open3dengineering/i3_Berlin/Firmware/RUMBA/README.md

Marlin Firmware for the I3 Berlin
=============

This is a preconfigured Marlin Firmware for the O3DE-Prusa I3. 

*original [https://github.com/ErikZalm/Marlin/](https://github.com/ErikZalm/Marlin/).*

Installation Instructions:
-------------
* Download Arduino 1.0.5 from *[http://arduino.cc/en/Main/Software](http://arduino.cc/en/Main/Software).*
* Install /ArduinoAddons/Arduino_1.x.x/u8glib_arduino_v1.12.zip into your Arduino library directory *see [http://arduino.cc/en/Guide/Libraries](http://arduino.cc/en/Guide/Libraries)*
* To use the RUMBA board on Windows 8/7/Vista/XP 32 and 64 bit install the USB driver from [http://reprap.org/wiki/File:RRD_RUMBA_TAURINO_DriverSetup.zip](http://reprap.org/wiki/File:RRD_RUMBA_TAURINO_DriverSetup.zip)
* If you have a songle Extruder cp the file Configuration.h.single to Configuration.h, for a dual Extruder cp Configuration.h.dual to Configuration.h 
* Open /Marlin/Marlin.ino with the Arduino IDE 
* set your Boardtype to "Arduino Mega 2560" and select the coresponding serial interface
* upload the Firmware ( File->Upload )
