open3dengineering/i3_Berlin/Stls/CableHolder.stl

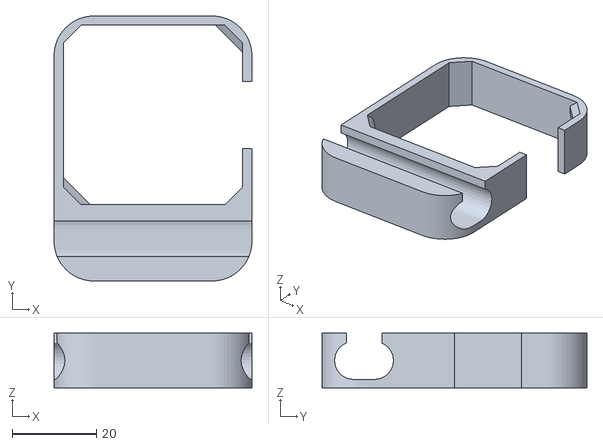
[picture p2: CAD file, 2015-07-06]
Stls/CableHolder.stl
47.1 x 63.1 x 13.0
