open3dengineering/i3_Berlin/Stls/ExtruderCenterRight.stl

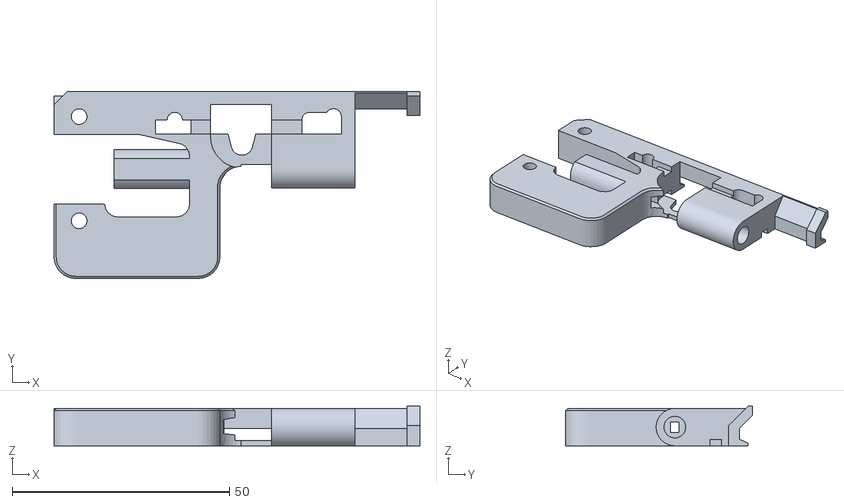
[picture p3: CAD file, 2015-04-21]
Stls/ExtruderCenterRight.stl
84.2 x 43.0 x 9.10
