open3dengineering/i3_Berlin/Stls/X_Carriage.stl

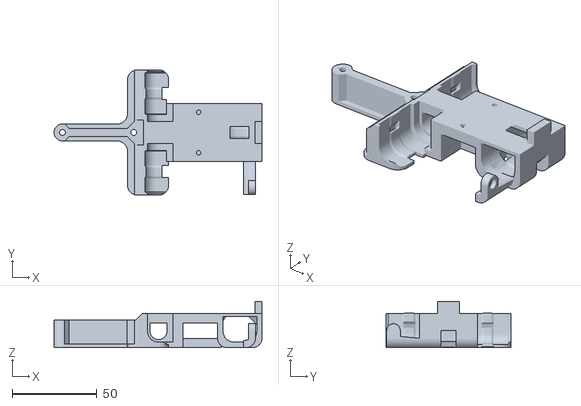
[picture p4: CAD file, 2015-04-21]
Stls/X_Carriage.stl
122.7 x 74.0 x 27.2
