open3dengineering/i3_Berlin/Stls/Y_Teeth.stl

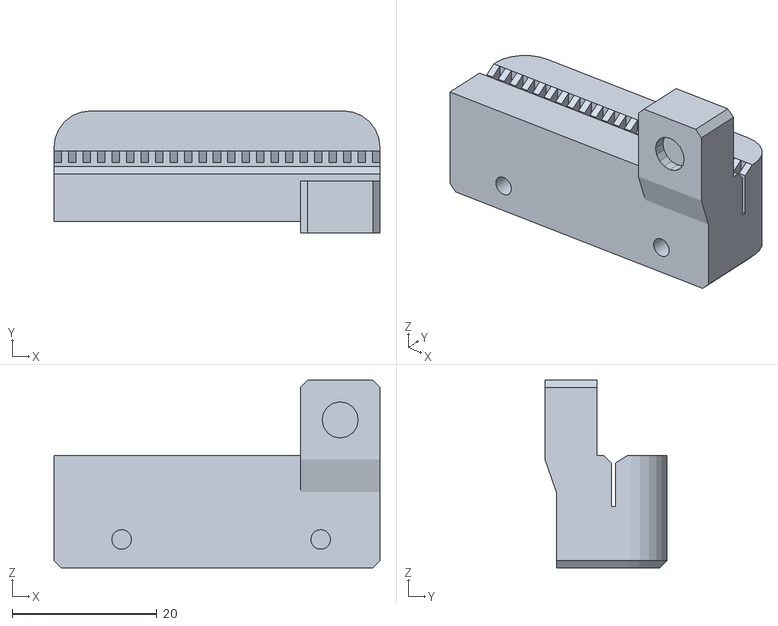
[picture p5: CAD file, 2015-02-04]
Stls/Y_Teeth.stl
45.0 x 16.9 x 25.9
