open3dengineering/i3_Berlin/Stls/Z_MotorLeft.stl

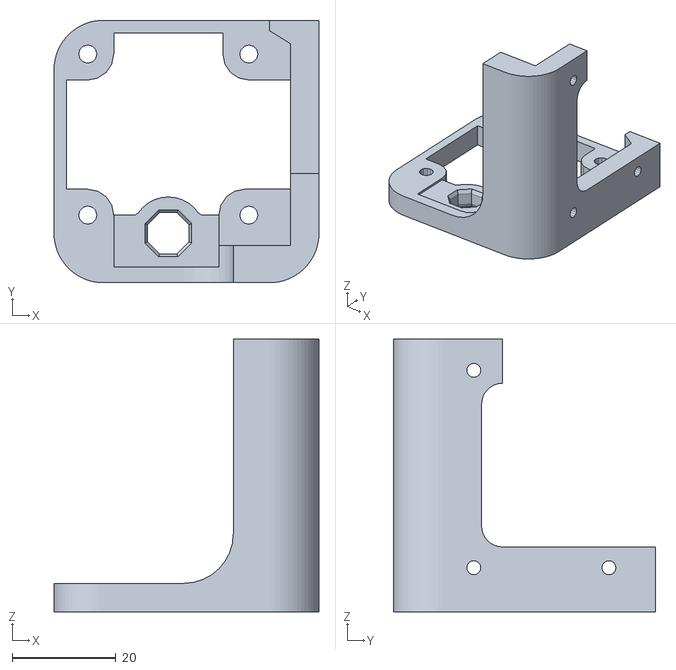
[picture p6: CAD file, 2015-02-04]
Stls/Z_MotorLeft.stl
51.0 x 50.5 x 52.5
