open3dengineering/i3_Berlin/Stls/Y_HeightAdjuster.stl

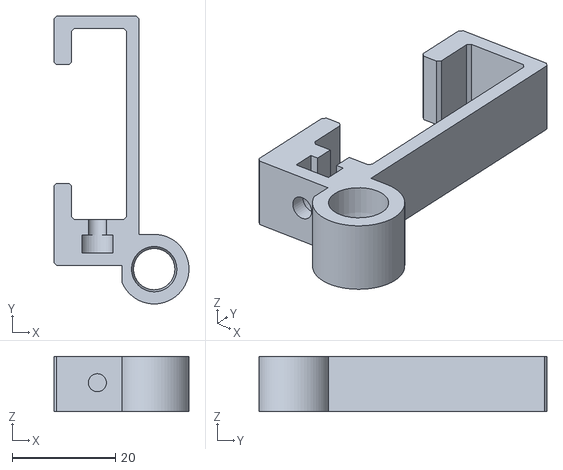
[picture p7: CAD file, 2015-02-04]
Stls/Y_HeightAdjuster.stl
26.1 x 55.7 x 10.7
