open3dengineering/i3_Berlin/Stls/DisplayCaseCorner.stl

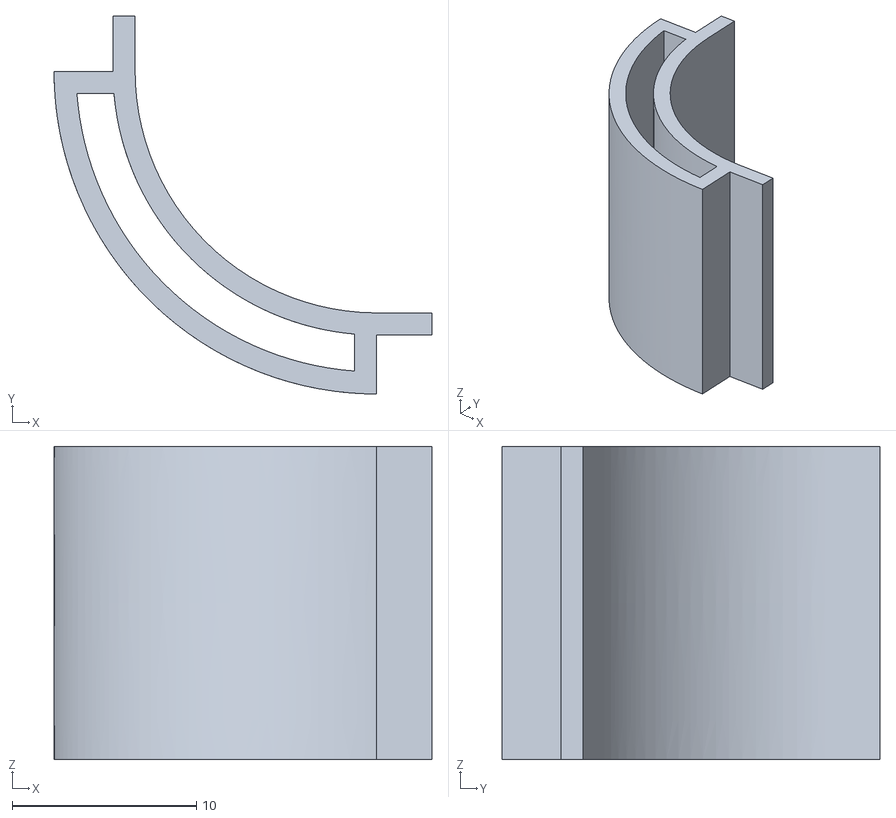
[picture p8: CAD file, 2015-02-04]
Stls/DisplayCaseCorner.stl
20.5 x 20.5 x 17.0
