open3dengineering/i3_Berlin/Stls/Z_TopLeft.stl

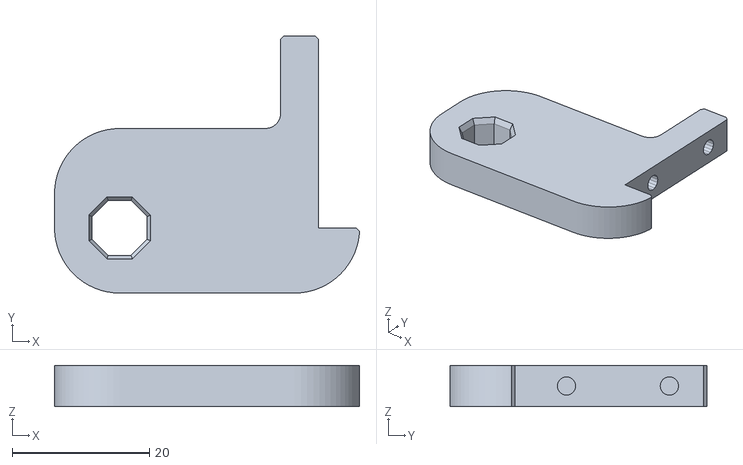
[picture p9: CAD file, 2015-02-04]
Stls/Z_TopLeft.stl
44.5 x 37.5 x 6.00
