open3dengineering/i3_Berlin/Stls/Y_FrontRight.stl

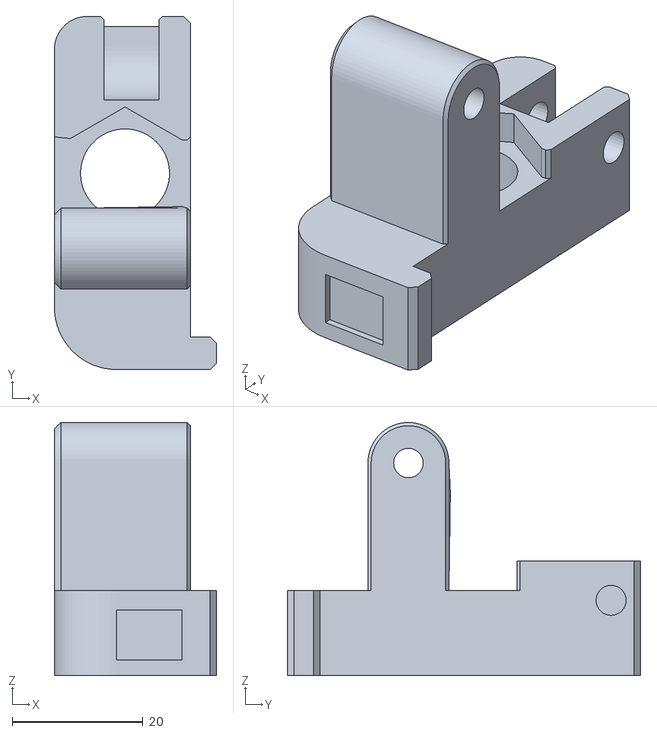
[picture p10: CAD file, 2015-02-04]
Stls/Y_FrontRight.stl
24.8 x 54.0 x 38.7
