open3dengineering/i3_Berlin/Stls/XZ_BearingHolderRight.stl

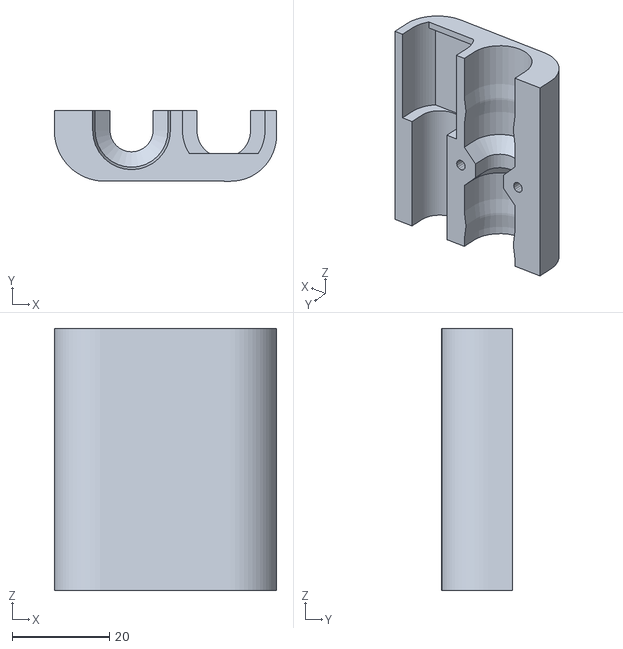
[picture p11: CAD file, 2015-02-04]
Stls/XZ_BearingHolderRight.stl
45.8 x 14.5 x 54.0
