open3dengineering/i3_Berlin/Stls/RUMBA_Case_SmallCorner.stl

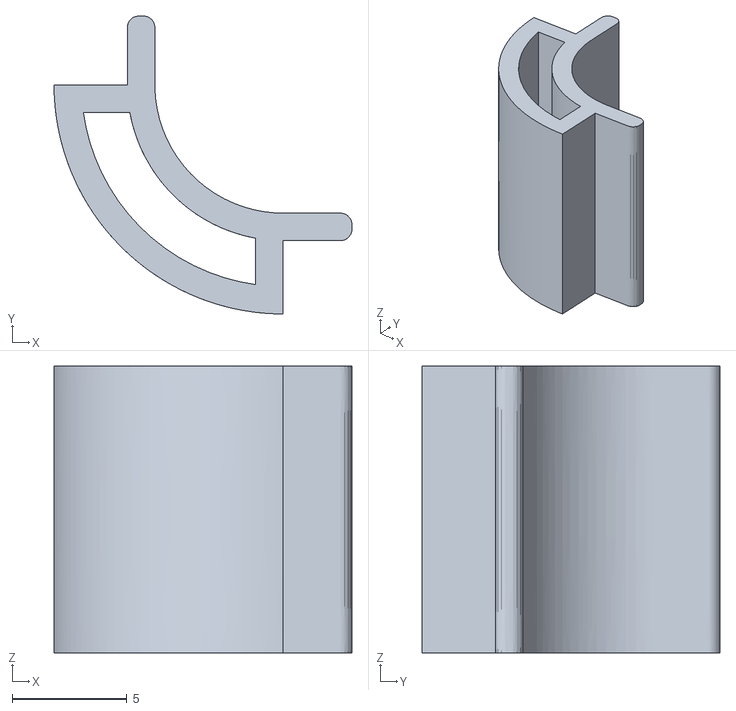
[picture p12: CAD file, 2015-02-04]
Stls/RUMBA_Case_SmallCorner.stl
13.0 x 13.0 x 12.5
