open3dengineering/i3_Berlin/Stls/RUMBA_Case_FanHolder.stl

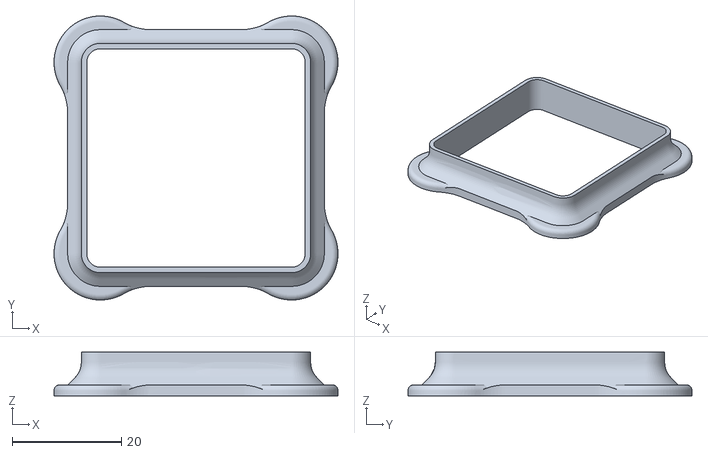
[picture p13: CAD file, 2015-02-04]
Stls/RUMBA_Case_FanHolder.stl
52.0 x 52.0 x 8.00
