open3dengineering/i3_Berlin/Stls/XZ_BearingHolderLeft.stl

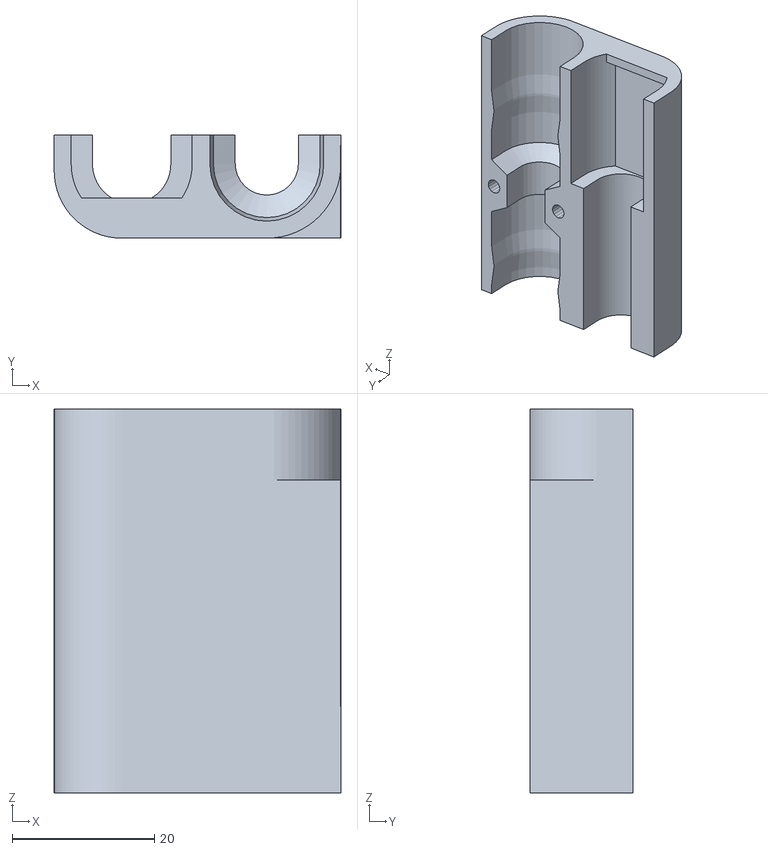
[picture p14: CAD file, 2015-02-04]
Stls/XZ_BearingHolderLeft.stl
40.3 x 14.5 x 54.0
