open3dengineering/i3_Berlin/Stls/Y_Motor.stl

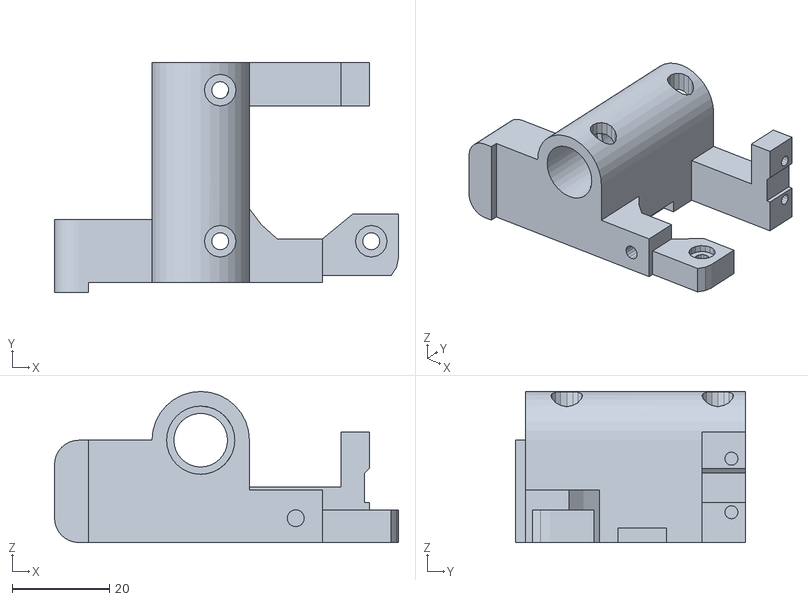
[picture p15: CAD file, 2015-02-04]
Stls/Y_Motor.stl
70.6 x 47.1 x 31.0
