open3dengineering/i3_Berlin/Stls/RUMBA_Case_LargeCorner.stl

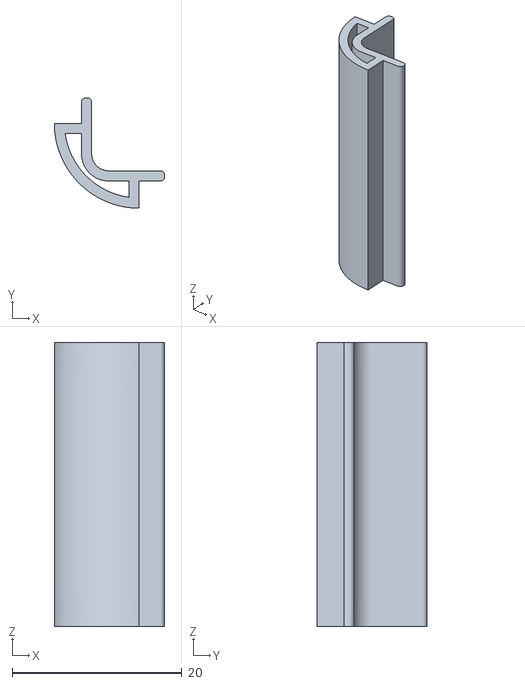
[picture p16: CAD file, 2015-02-04]
Stls/RUMBA_Case_LargeCorner.stl
13.0 x 13.0 x 33.4
