open3dengineering/i3_Berlin/Stls/ExtruderFanHolder.stl

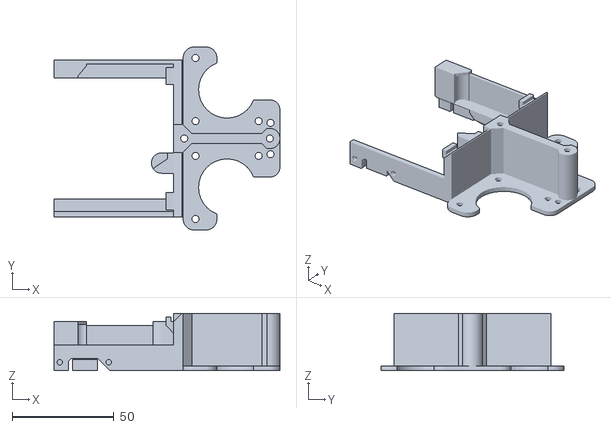
[picture p17: CAD file, 2015-02-04]
Stls/ExtruderFanHolder.stl
111.0 x 90.0 x 28.2
