open3dengineering/i3_Berlin/Stls/Y_BackLeft.stl

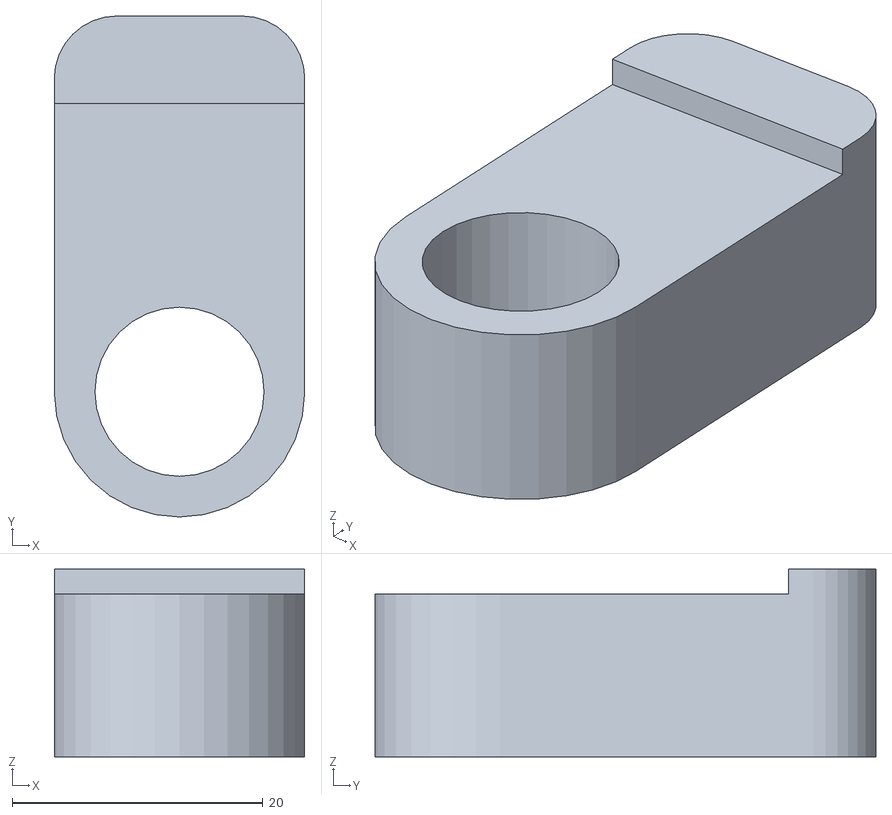
[picture p18: CAD file, 2015-02-04]
Stls/Y_BackLeft.stl
20.0 x 40.0 x 15.0
