open3dengineering/i3_Berlin/Stls/PowerConnectorCover.stl

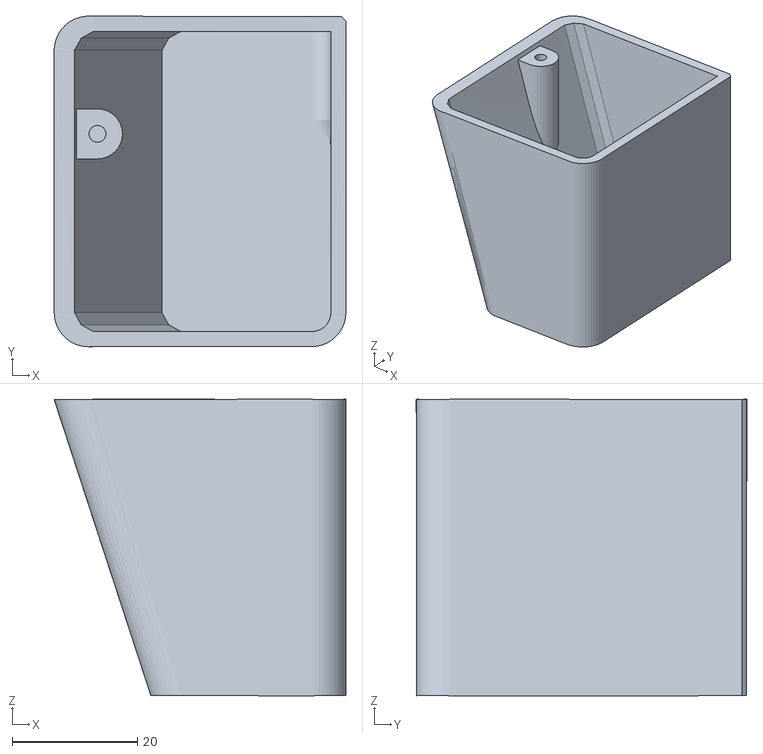
[picture p19: CAD file, 2015-02-04]
Stls/PowerConnectorCover.stl
46.7 x 52.9 x 47.5
