open3dengineering/i3_Berlin/Stls/Y_MiddleLeft.stl

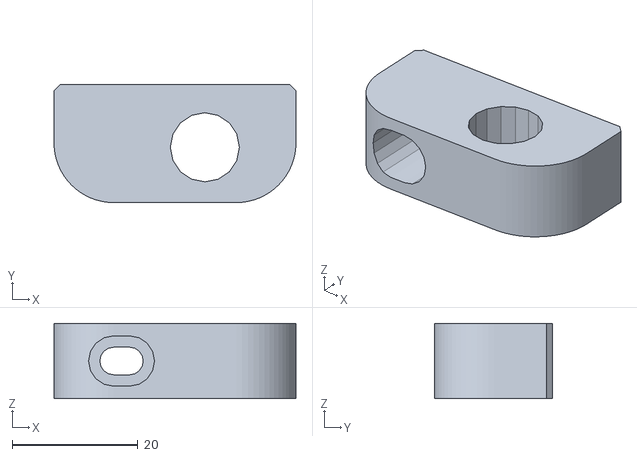
[picture p20: CAD file, 2015-02-04]
Stls/Y_MiddleLeft.stl
38.5 x 18.8 x 12.0
