open3dengineering/i3_Berlin/Stls/X_Idler.stl

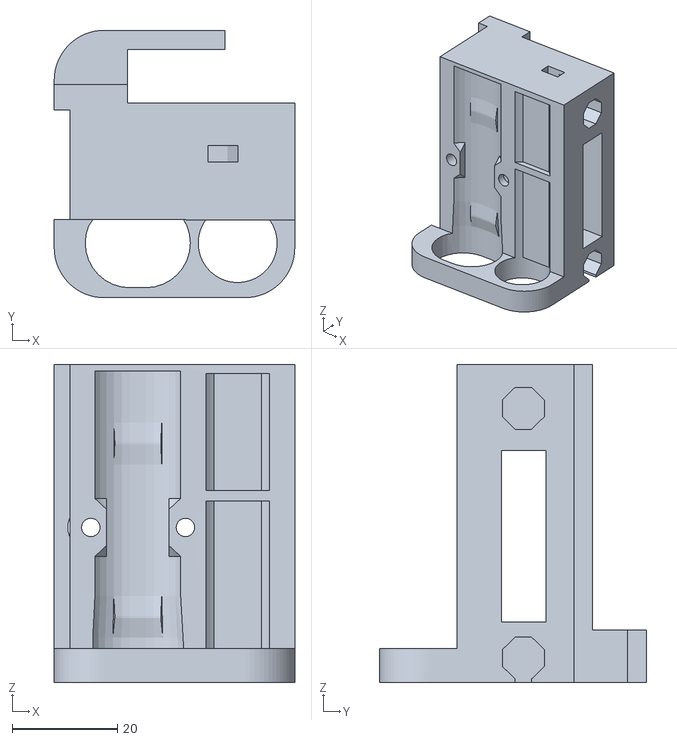
[picture p21: CAD file, 2015-02-04]
Stls/X_Idler.stl
45.8 x 50.9 x 60.5
