open3dengineering/i3_Berlin/Stls/ActiveCoolingDuct.stl

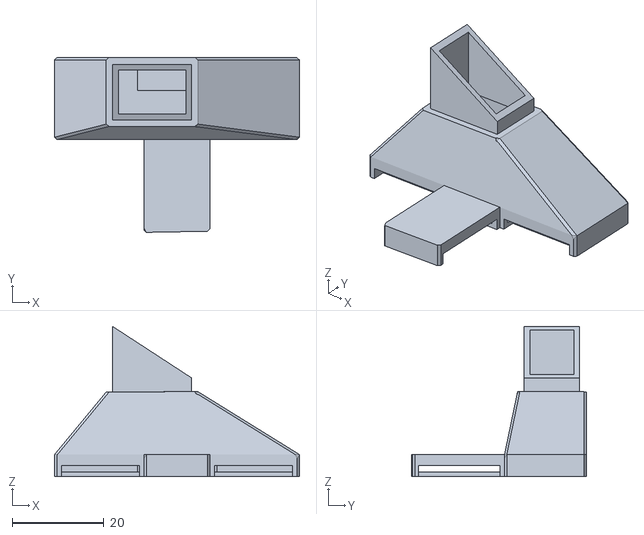
[picture p22: CAD file, 2015-02-04]
Stls/ActiveCoolingDuct.stl
53.4 x 38.1 x 32.7
