open3dengineering/i3_Berlin/Stls/BeltGuidingDisc.stl

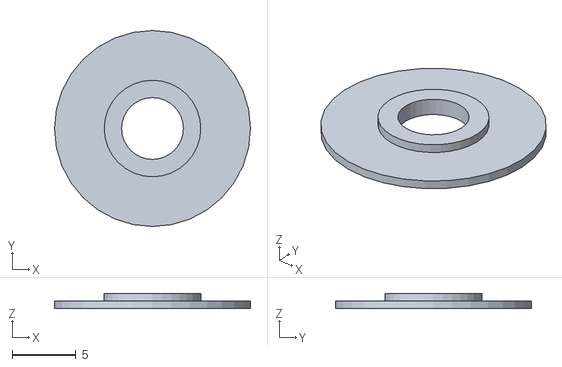
[picture p23: CAD file, 2015-02-04]
Stls/BeltGuidingDisc.stl
15.4 x 15.4 x 1.20
