open3dengineering/i3_Berlin/Stls/Y_FrontLeft.stl

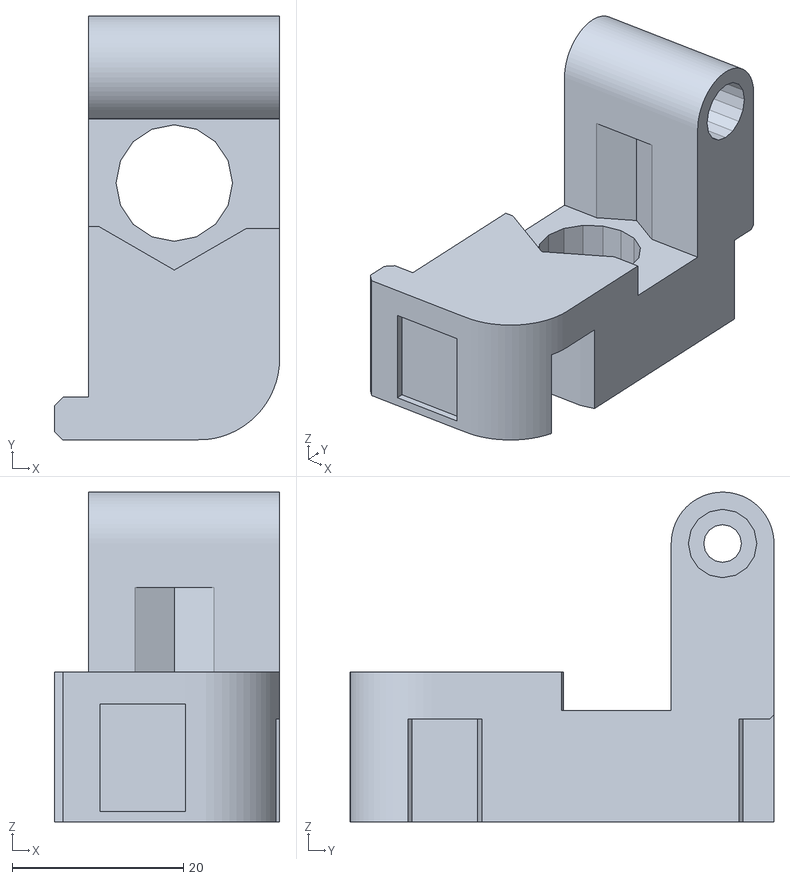
[picture p24: CAD file, 2015-02-04]
Stls/Y_FrontLeft.stl
26.3 x 49.5 x 38.5
