open3dengineering/i3_Berlin/Stls/RUMBA_Case_Inlet.stl

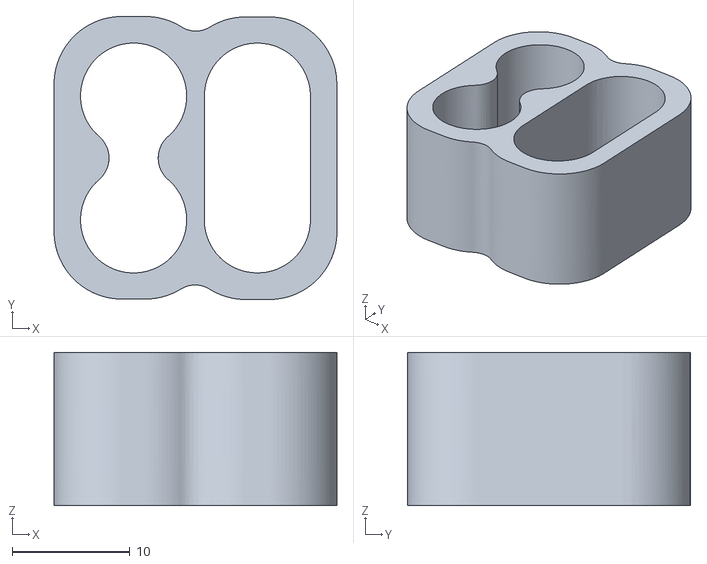
[picture p25: CAD file, 2015-02-04]
Stls/RUMBA_Case_Inlet.stl
24.0 x 24.0 x 13.0
