open3dengineering/i3_Berlin/Stls/X_Motor.stl

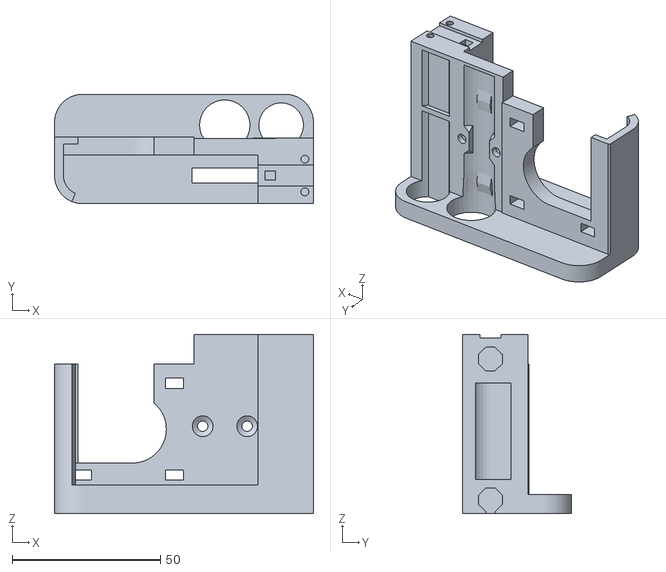
[picture p26: CAD file, 2015-02-04]
Stls/X_Motor.stl
87.3 x 36.9 x 60.5
