open3dengineering/i3_Berlin/Stls/Y_MiddleRight.stl

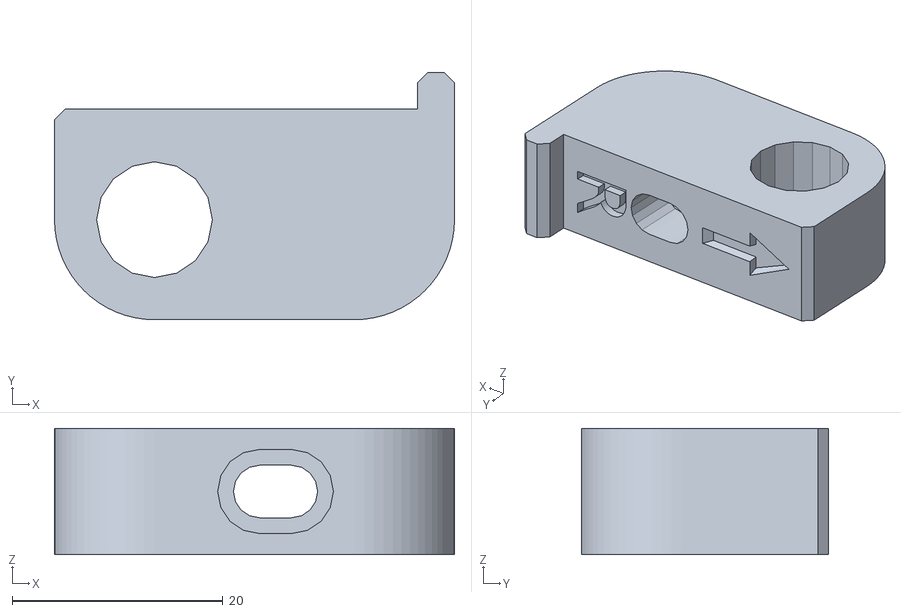
[picture p27: CAD file, 2015-02-04]
Stls/Y_MiddleRight.stl
38.0 x 23.5 x 12.0
