open3dengineering/i3_Berlin/Stls/Extruder_E3D_FanDuct.stl

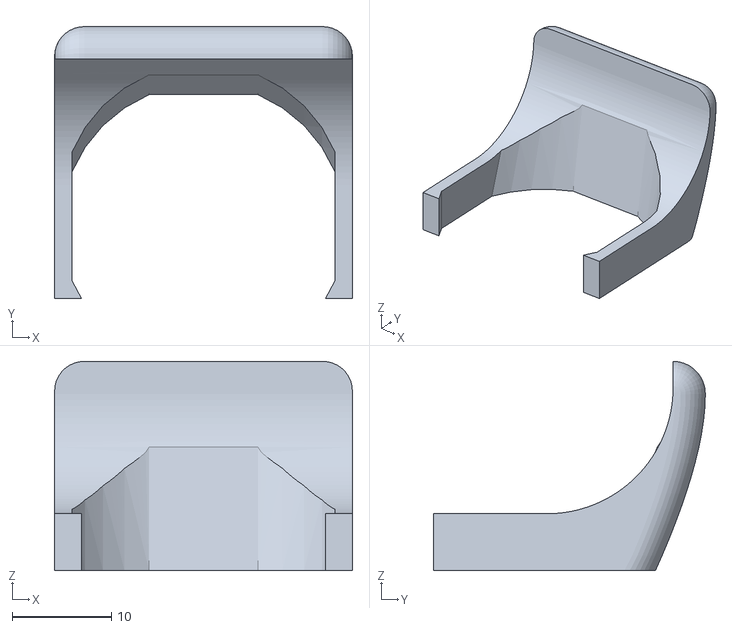
[picture p28: CAD file, 2015-02-04]
Stls/Extruder_E3D_FanDuct.stl
30.0 x 27.4 x 21.1
