open3dengineering/i3_Berlin/Stls/X_Teeth.stl

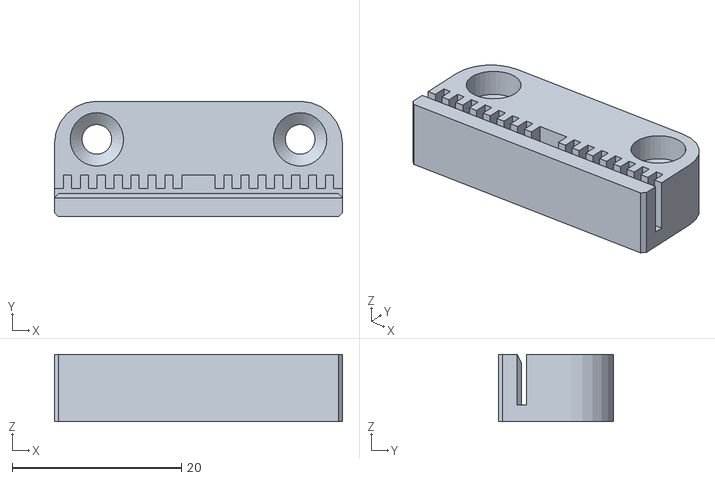
[picture p29: CAD file, 2015-02-04]
Stls/X_Teeth.stl
34.0 x 13.6 x 7.94
