open3dengineering/i3_Berlin/Stls/PowerSupplyCover.stl

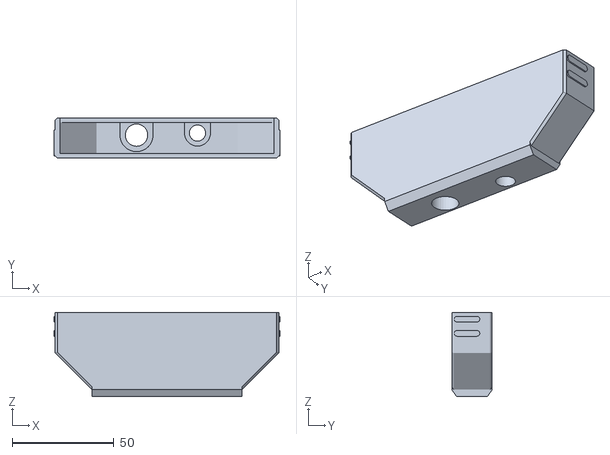
[picture p30: CAD file, 2015-02-04]
Stls/PowerSupplyCover.stl
111.2 x 19.9 x 41.6
