open3dengineering/i3_Berlin/Stls/Z_TopRight.stl

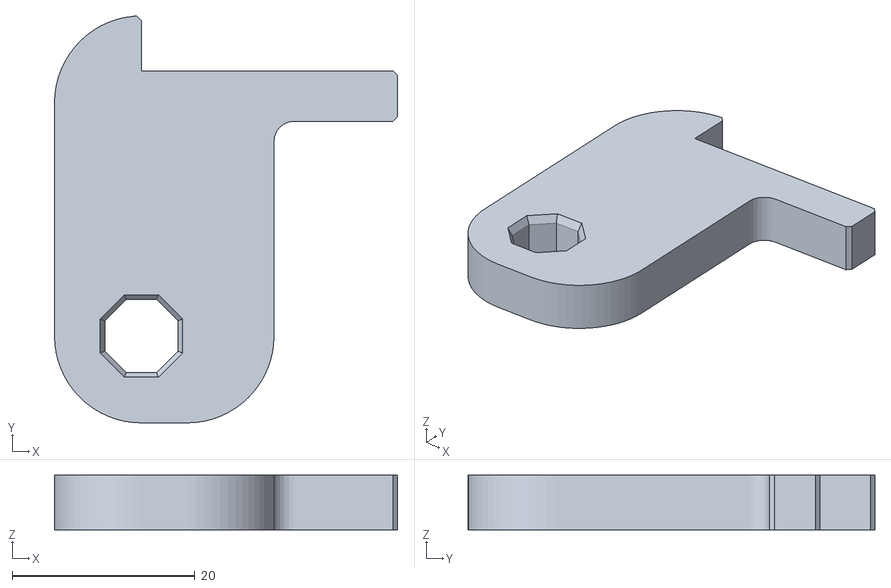
[picture p31: CAD file, 2015-02-04]
Stls/Z_TopRight.stl
37.5 x 44.5 x 6.00
