open3dengineering/i3_Berlin/(list of files, cad)

Other CAD files:
Frame/i3_berlin_frame.dxf
Stls/ExtruderCenterLeft.stl
Stls/Z_MotorRight.stl
