open3dengineering/i3_Berlin/(threads)

Thread 1 (2013-09-20):

Printed Parts

vela3, 2013-09-20:
Design changes needed in the printed parts are:

X Axis
- [ ] X-Idler: Change M4 screw for dowel
- [ ] X-Idler: Bigger hole for screwdriver
- [x] Cable Holder: New Logo
- [ ] Cable Holder: Shouldn't fall of
- [x] Cable Holder: Round it up
- [ ] Prevent Z-Bearings to fall out
- [x] Make X-Motor and Idler more Round
- [ ] X-Carriage: Prepare for IGUS bearings
- [x] X-teeth with plastic screws
- [ ] X-Carriage: Better fixing to fanholder part with extra nodge
- [x] X-Carriage - no magnet slot: put it in
- [x] Cable holder with logo and red printed plate on the back
- [x] Better clamping for x rods.
- [x] Logical place for the x-teeth
- [x] Anvil for lower x-rod in motor holder so it can´t slide out

Y Axis
- [x] Y-Front Right: more space for idlerbearing axis: make it with a dowel pin.
- [ ] Change bed leveling mechanism (no de-adjusting during printing).
- [ ] Prepare for IGUS Bearings
- [ ] Rubber feet in all 4 corners + Z motors holders.
- [x] Make Y corners more round
- [x] Y-Teeth: Print in ABS
- [x] Y-Teeth: Fix withPlastic screws (Change frame as well!)
- [x] Y Front - mounting hole should be the M4 mounting hole on the side and not the m3 PCB hole on the bottom
- [x] Y-Beltholder - magnet support bumps into the power supply
- [x] Y-Beltholder - no room for zipties to secure the belt; use a double set of teeth??
- [x] Y-Motor - The belt tension causes unstraightness and probably squeeky sounds
- [x] Power Supply - Up side down
- [x] knobs for bed leveling smaller, and spiral shape to make clear which direction is up and down.
- [x] test several springs for the hotbed
- [x] Third screw for Y-Motor to keep it straight
- [x] Left and Right marks for middle PSU holders
- [x] More convenient Y Endstop cable assembly
- [x] Mechanism to adjust the Y-motion parallel
- [ ] Vibration Isolation from the Y-Rods

Z Axis
- [ ] Right ACME seems to be unstraight
- [ ] Integrate bearing holder into one part.
- [x] Z-Top: Thin wall to hide the screw
- [x] Z-Top: Inner radius
- [x] Z-EndstopHolder: Change it
- [x] Bottom Z	- bridge for the motor screw holes instead of tiny breakout supports (done 19-9 BdV)
- [x] Bottom Z	- The clamps for the rods need extra support for printing, now it´s a bit ugly (done 19-9 BdV)
- [x] Bottom Z	- The holder on the right needs a little slit for the Z endstop wire to go through
- [x] M5 Tops - They are a bit too low
- [x] Anti wobble - Lower the Z-Bottom parts, so the printer only stands on the front and the back and never wobbles.
- [x] Z Endstop doesn´t fit for the first 8 plates due to bad milling
- [x] Z-Endstop to the back for more adjustment freedom
- [x] Plastic nut with anti backlash or ball spindle (ACME rods are sufficient)

Extruder
- [ ] Slide in radial fan (no more screws).
- [ ] E3D fanholder: Same on both sides
- [x] ExtruderCenterPiece: Take of little edge of the center piece to avoid collision with screw of filament pulley
- [x] ExtruderCenterPiece: Add little edge in cable channel, to avoid cable clamping between aluminium
- [ ] ActiveCoolingDuct: better design for better cooling
- [x] Active cooling
- [ ] Light on the nozzle
- [ ] Ready for 3mm, test also with flex materials
- [x] Direct drive extruder, lower the extruder to increase built volume.

Casing and rest
- [x] Update for small endstop
- [x] SpoolHolder: more distance 5mm
- [x] SpoolHolder: Round it up
- [ ] RumbaCaseBottom: Better cable inlet holes
- [ ] RumbaCaseBottom: Some hooks on the inside
- [ ] PowerSupplyCover: Fitting to the new power supply.
- [ ] PowerSupplyCover: Fix with screw
- [ ] PowerSupplyCover: Seperate cable entry
- [x] PowerConnectorCover: Better entry for the cable
- [x] PowerConnectorCover: Fix with plastic screw. (change alu plate as well!)
- [x] PowerConnectorCover: Better holding the ring + teeth washer
- [x] PowerConnectorCover: Better clamping of the power connector.
- [ ] Display knob redesign
- [ ] All screws Torx
- [x] Display casing: better support for button pushing
- [x] Display casing: better mounting to frame with anvil for clear end.
- [x] Display casing: knob
- [x] Lower aluminium frame for better passing of power cables
- [ ] Bowden tube - would be nice to have a bowden to guide the filament. Can only work if the extruder part has some hole to keep the tube in place
- [x] Ask Gemmel for less rusty rods. Answer: Rods can rust.
- [x] Extruder moves a bit when extruding
- [x] Spoolholder as a tool to screw in M5 threaded rods
- [x] Nicer holes for endstop covers
- [x] Idler for the extruder doesn´t quite fit
- [x] Power Cable with connection
- [x] Ground leech for machine safety
- [x] Nice box for shipping kits
- [x] Use plastic screws

Closed 2015-06-18.

Thread 13 (2014-09-09):

Extruder zieht Filament nicht korrekt...

Paulebomber, 2014-09-09:
Hallo i3 Berlin Team,
Ich hatte es ja neulich schon, mit dem Filament, welches im Extruder hängen bleibt und nicht ins Hot End gelangt...
Das Problem schien durch anderes Filament gelöst...
Doch das selbe Filament lässt sich jetzt nicht mehr drucken...
Jetzt meine Frage: gibt es die Möglichkeit, sich mit euch zu treffen, um das Problem gemeinsam zu lösen?
Lg,
Paul

Closed 2015-06-18.

Thread 14 (2014-09-29):

Manual updates

vela3, 2014-09-29:
Fitting Y Idler bigger hole in guiding discs
Y-Endstop later
Distance Y pulley

XZ plate in sparkle x endstop wrong

M4 trick to make Y straight

Closed 2015-06-18.

Thread 17 (2015-01-05):

Upgrading Dual Extruder Parts

Paulebomber, 2015-01-05:
Hey, da mein Drucker mittlerweile tadellos läuft und druckt, wollte ich mal fragen welche Teile ihr für den Extruder verwendet also z.B. welchen Stepper-Motor könnt ihr empfehlen?
Hot-End müsste ja das E3D sein...
Ich glaube, dass ich V5 habe, sollte ich das andere auch als V5 oder V6 nehmen?
Welchen Thermistor benötige ich?
Letzte und vielleicht entscheidene Frage: Woher bekomme ich die Teile am besten?
Wäre super nett, wenn ihr mich bei der Idee dual-Extruder unterstützen könntet
LG und Vielen Dank,
Paul

ugu, 2015-01-05:
Hello Paul,

You can get all the parts directly from us, if you already own a V5, we advise you to continue with it as we don't have the parts adjusted for 2 different versions (the V6 is 1 cm shorter in length...) we do have an upgrade that avoid most of the jamming problems the original E3D V5 had, we also added a self adjusting idler(with a spring) to be able to cope with filaments that are not so constant in diameter so we would suggest that you send us your original aluminium parts and we will make that upgrade without any additional cost...

Greetings
Hugo

(sorry for replying in English, but my written german sucks! :D )

Paulebomber, 2015-01-05:
Hey Hugo,
Thanks for your fast answer. How much would your kit cost?
Bran already told me about the spring idler and told me as well, that he is going to do it for me but the CNC machine has been broken. It would be no problem for me to meetup at some point, because I think it's a bit pointless to send the aluminum parts, while I live in Berlin
;)
Greetings
Paul

mangtronix, 2015-01-05:
Hi Hugo,

I have a dual extruder i3 Berlin and I'm also interested in the spring idler upgrade so I can print with experimental and self-extruded filaments.  I'm also in Berlin and I'll be at Fab Lab a few times this month.

I wonder if a v6 hotend with the new extended "Volcano" heater block would match the length of the v5 hotend. Unfortunately I haven't found any mechanical drawings and it looks like it's out of stock. Still cool though! http://e3d-online.com/blog/volcano_release

I'm currently using the v5 hotend with the v6 nozzle and I find the newer nozzle gives a slight improvement for jamming and retracts.  I got the v6 nozzle directly from E3D.

Best,
  - mang

ugu, 2015-01-09:
@Paulebomber  Sorry for replying late but sickness kicked in.... The upgrade Kit containing all the parts will cost you 150€.
As for the milling, the Cnc is fixed now, we are working on a date to do it and we are notifying all printer owners to send back their plates. We want to do it all at the same time to reduce the amount of work needed for the procedure. we will notify you with that as soon as the date is defined.

@mangtronix  looking at the pics of the Vulcano we also think it might work, but because we didn't got one yet we are not sure it will, but if you are willing to try that setup, we are here to help you with any problems that might come along.
We made our own custom nozzles for the V5 that work like charm in surface quality, but the problems with the Jamming and retracting are not coming from the nozzle, but the Heatbreak and Heatsink.
If you are coming to The Fablab this month we can discuss this subject a little more in detail...

Greetings to both....

Hugo

vela3, 2015-02-19:
Hi Paul,

This monday I would like to start milling the extruder upgrades.
Please mail me on info@laydrop(dot)com for more info.

Closed 2015-06-18.

Thread 21 (2015-03-18):

RUMBA z-Achse bekommt keinen Strom

mortkane, 2015-03-18:
Moin,
haben das Problem, das auf dem RUMBA manchmal kein Strom ankommt. Nach einer Weile Auszeit kommt wieder was an, nach 20 Minuten Laufzeit steigt die Stromzufuhr der Z-Achse aus.
Wir haben die Z-Achsen Stromzufuhr mal an die X-Achse gehängt, das lief tadellos.
Habt ihr eine Idee? Haben schon die Abdeckung entfernt, falls es ein Überhitzungsproblem ist.

Gruß, Martin

mortkane, 2015-03-19:
Offensichtlich Überhitzung. Mit Deckel ab - etwas besser. Muss wohl trotzdem eine aktive Lüftung drauf.

Closed 2015-03-19.

Thread 22 (2015-06-18):

i3 Berlin manual part list misses 2 images

morriswinkler, 2015-06-18:
there are two images in https://github.com/open3dengineering/i3_Berlin/wiki/Section-1.2-Tools-and-Parts
missing

* Power Cable
* Power Supply Sticker

Thread 23 (2015-10-02):

maybe an alternative for the current board?

tcurdt, 2015-10-02:
https://www.kickstarter.com/projects/1204283/zeropi-arduino-and-raspberry-pi-compatible-develop
