open3dengineering/i3_Berlin/Frame/PDF/i3_Berlin BackPlate.pdf

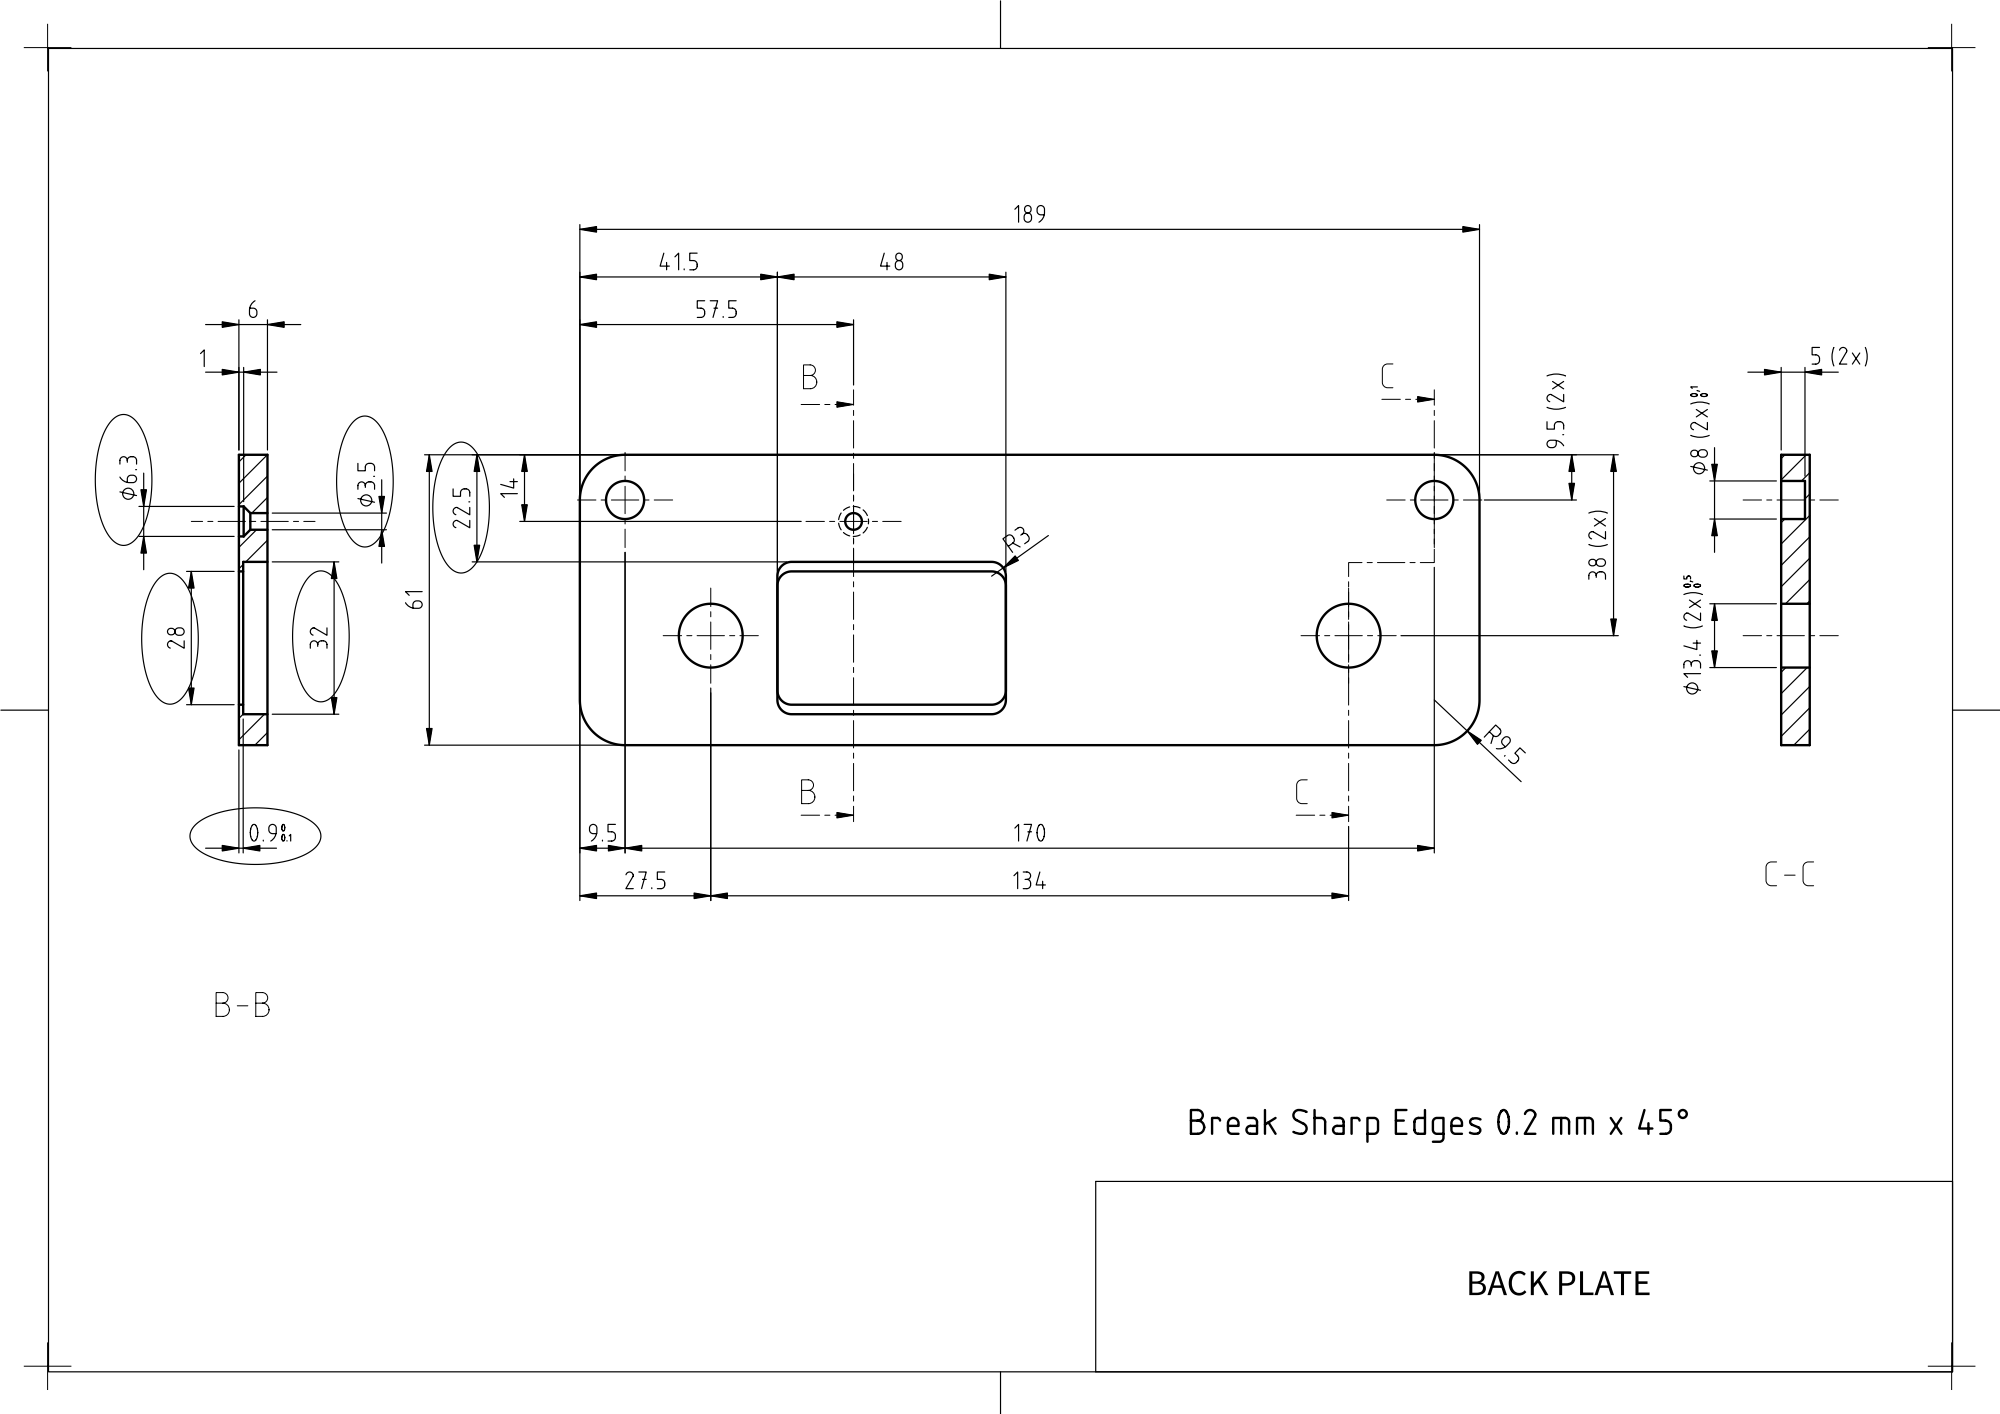
[picture p32: page 1]
