open3dengineering/i3_Berlin/Frame/PDF/i3_Berlin ExtruderBase.pdf

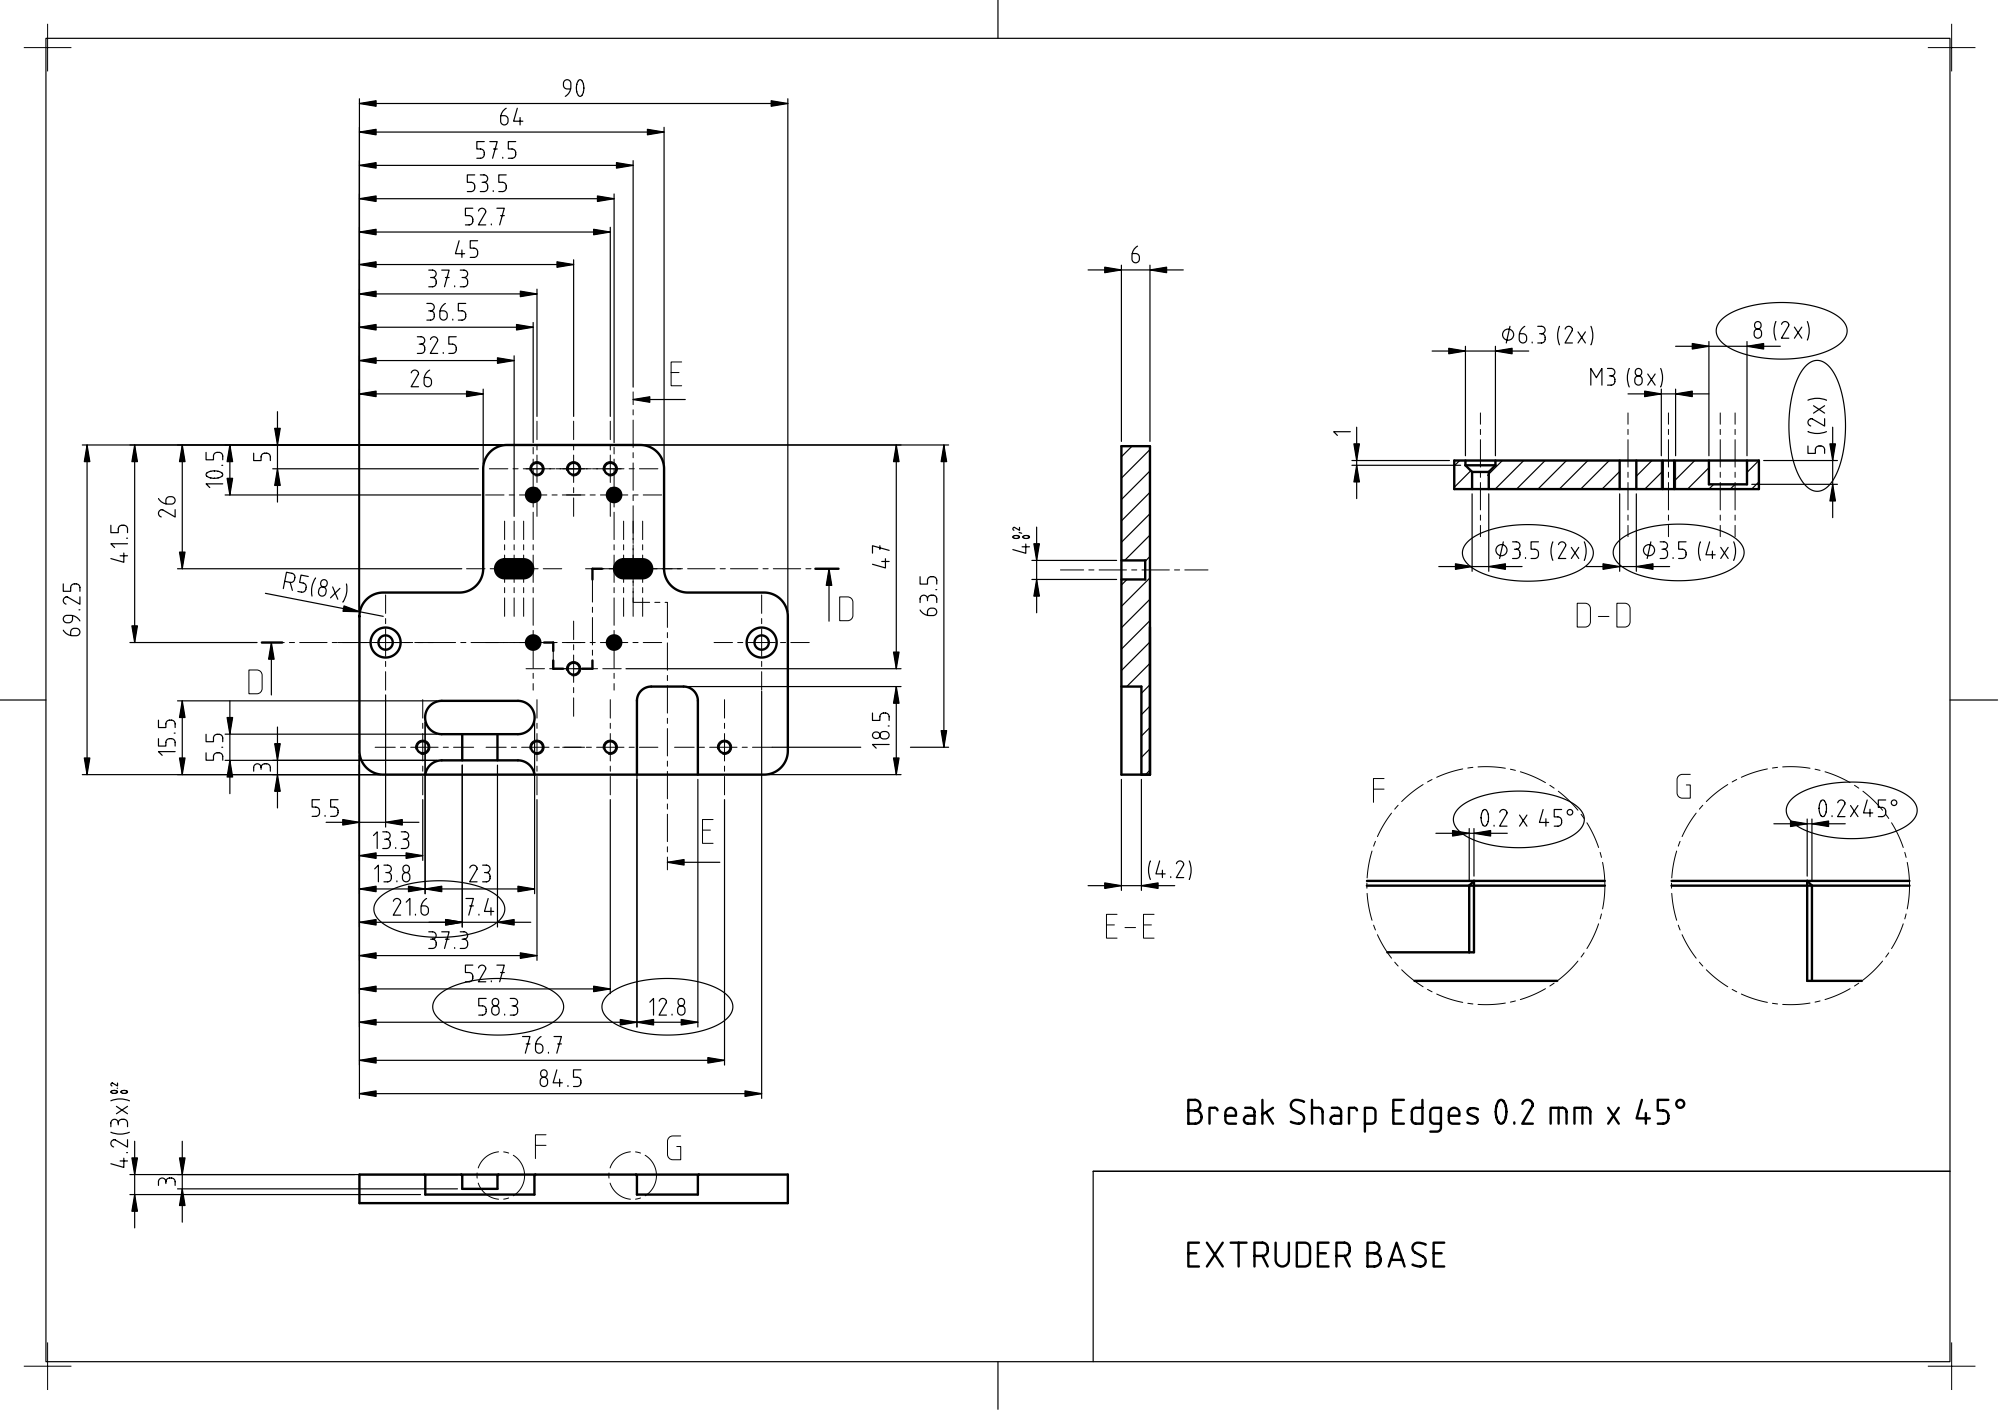
[picture p33: page 1]
