open3dengineering/i3_Berlin/Frame/PDF/i3_Berlin ExtruderFrontLeft.pdf

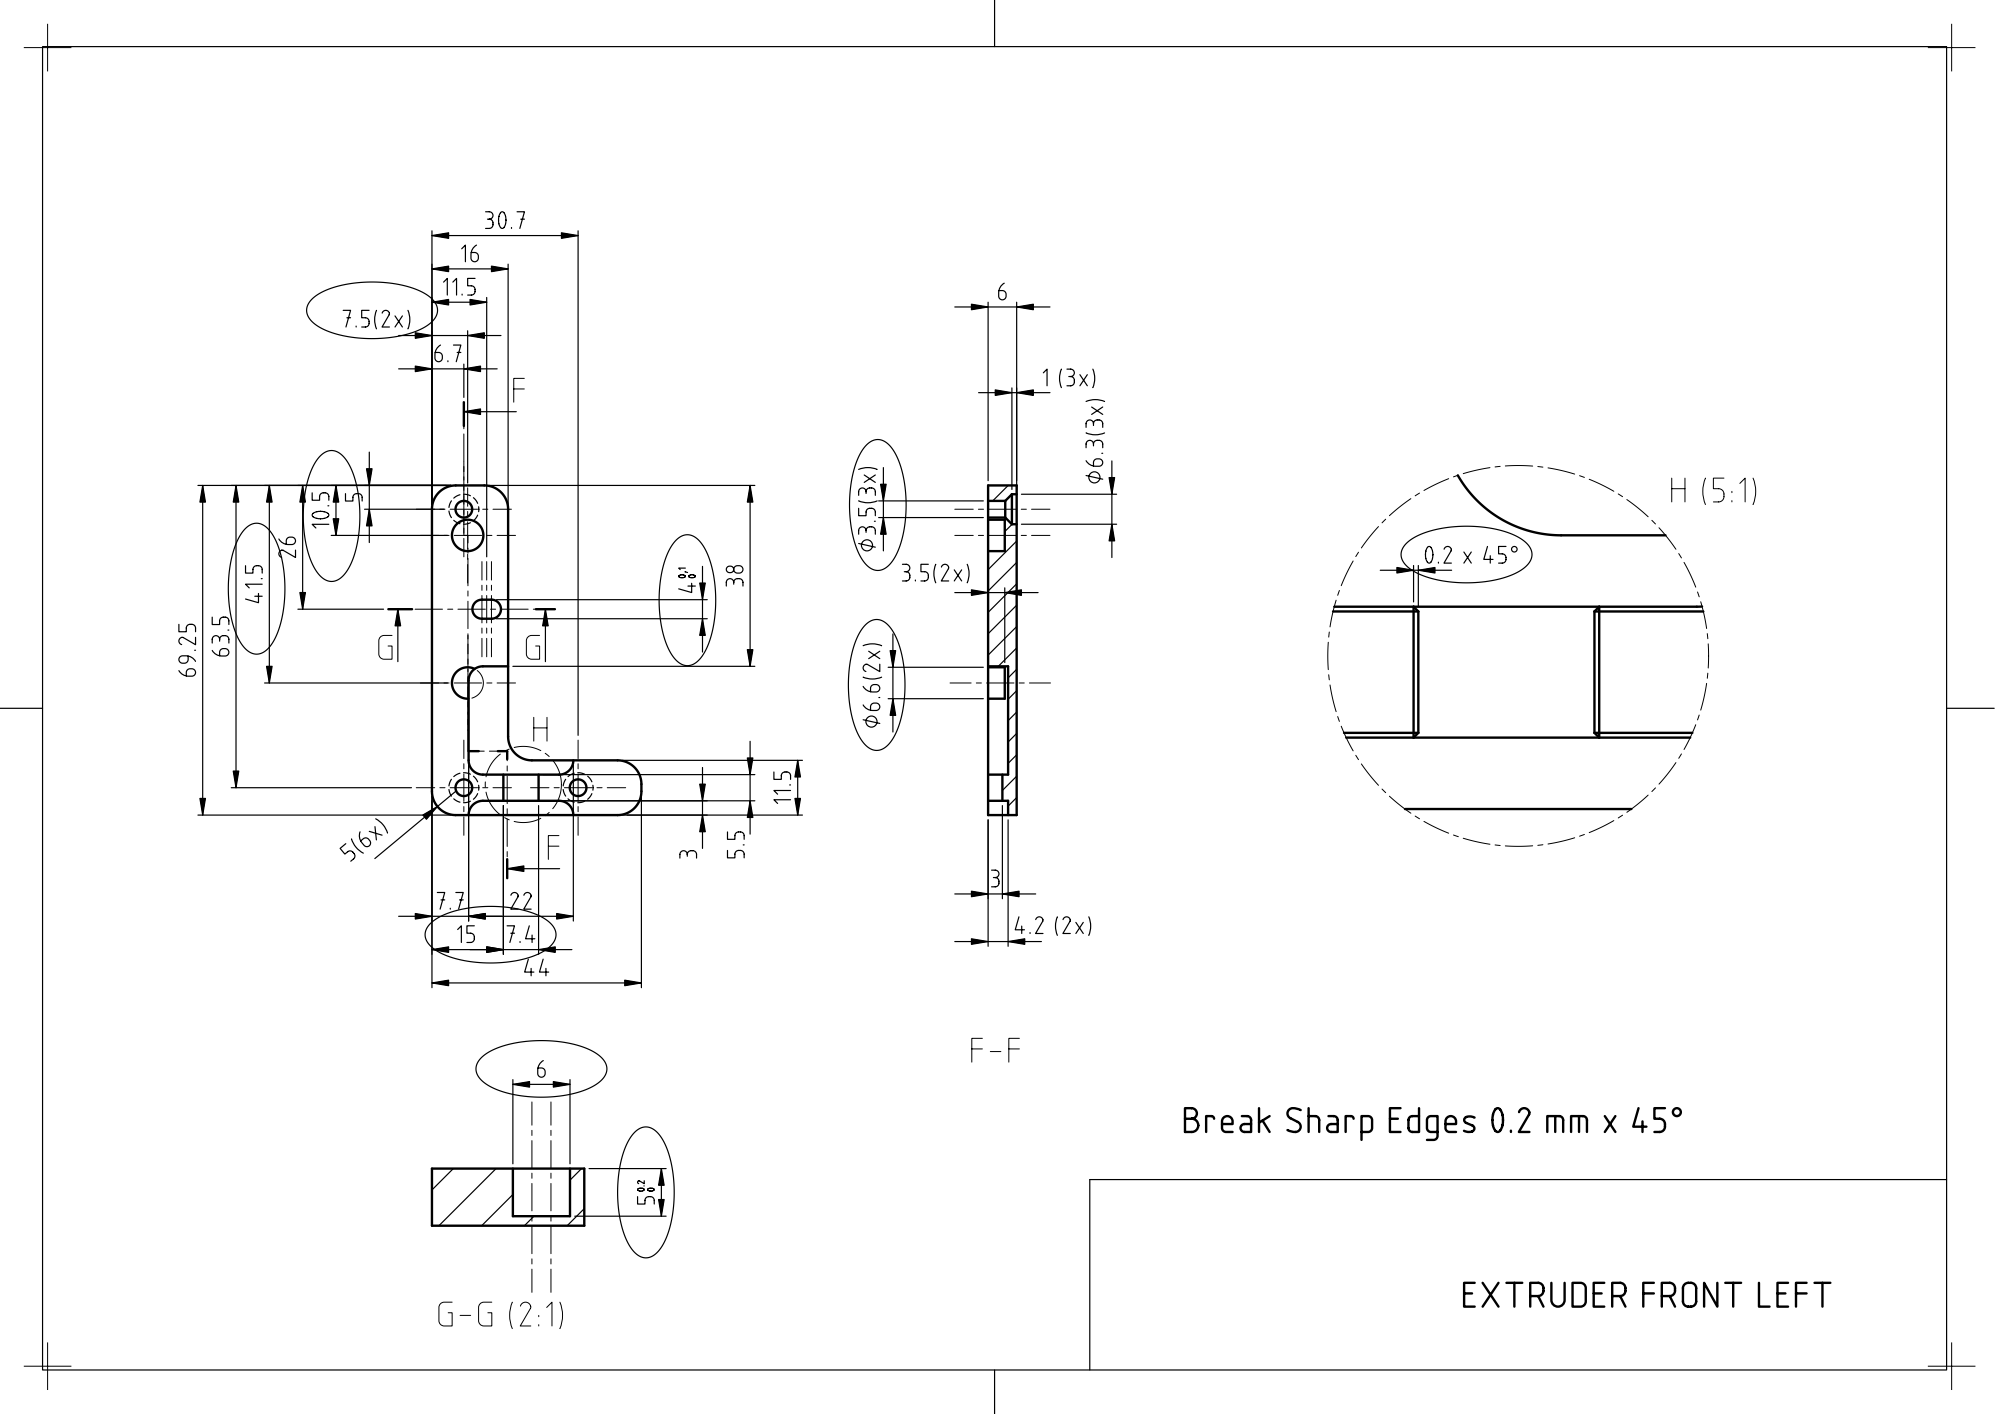
[picture p34: page 1]
