open3dengineering/i3_Berlin/Frame/PDF/i3_Berlin ExtruderFrontRight.pdf

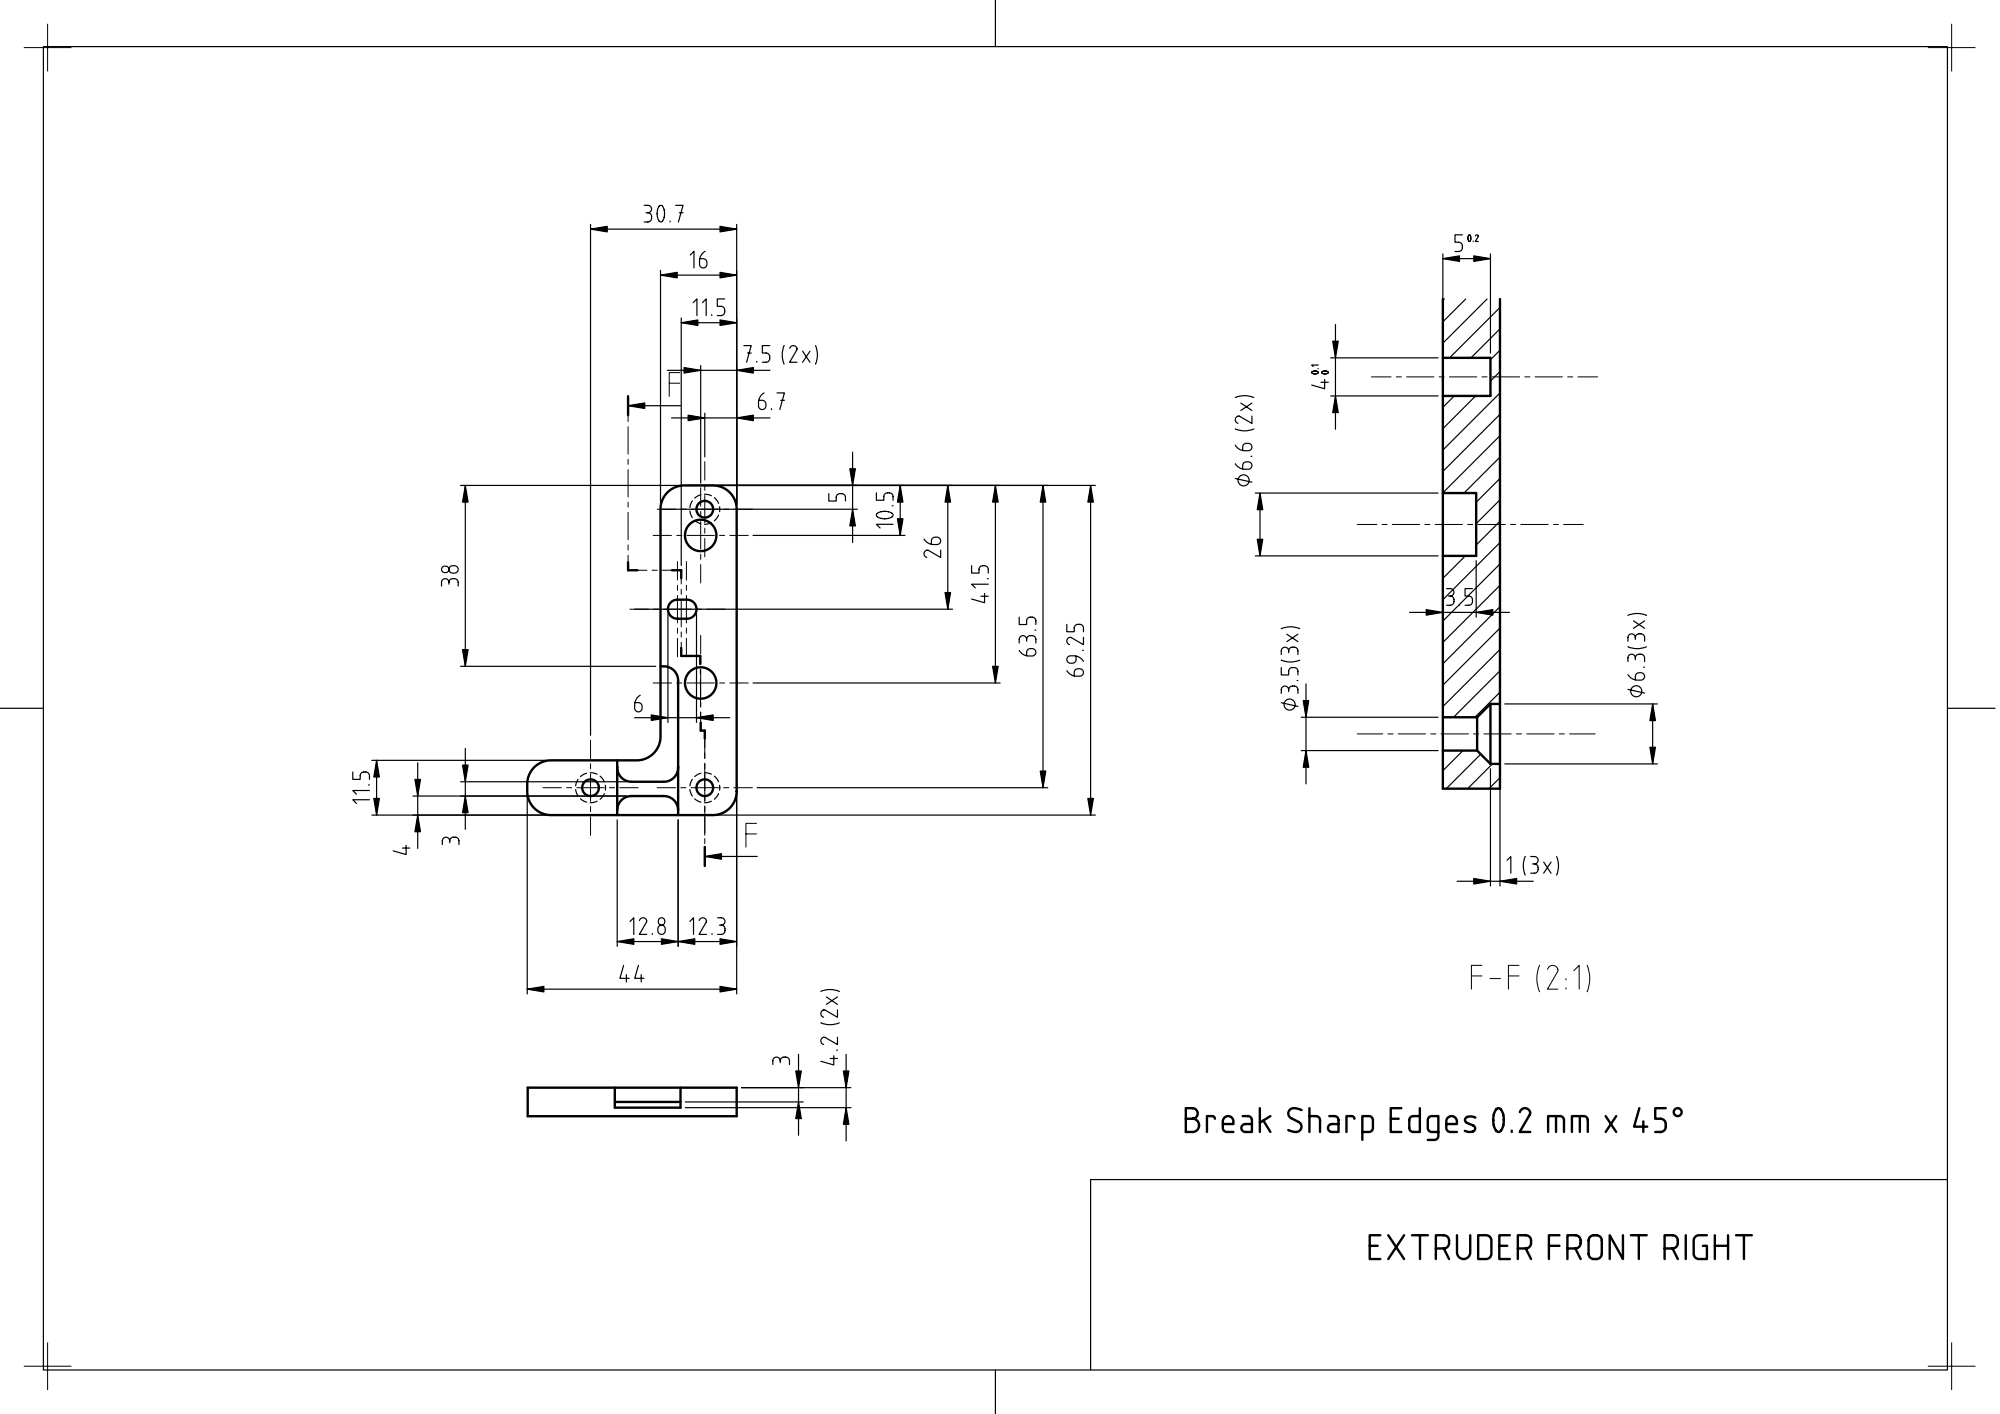
[picture p35: page 1]
