open3dengineering/i3_Berlin/Frame/PDF/i3_Berlin FrontPlate.pdf

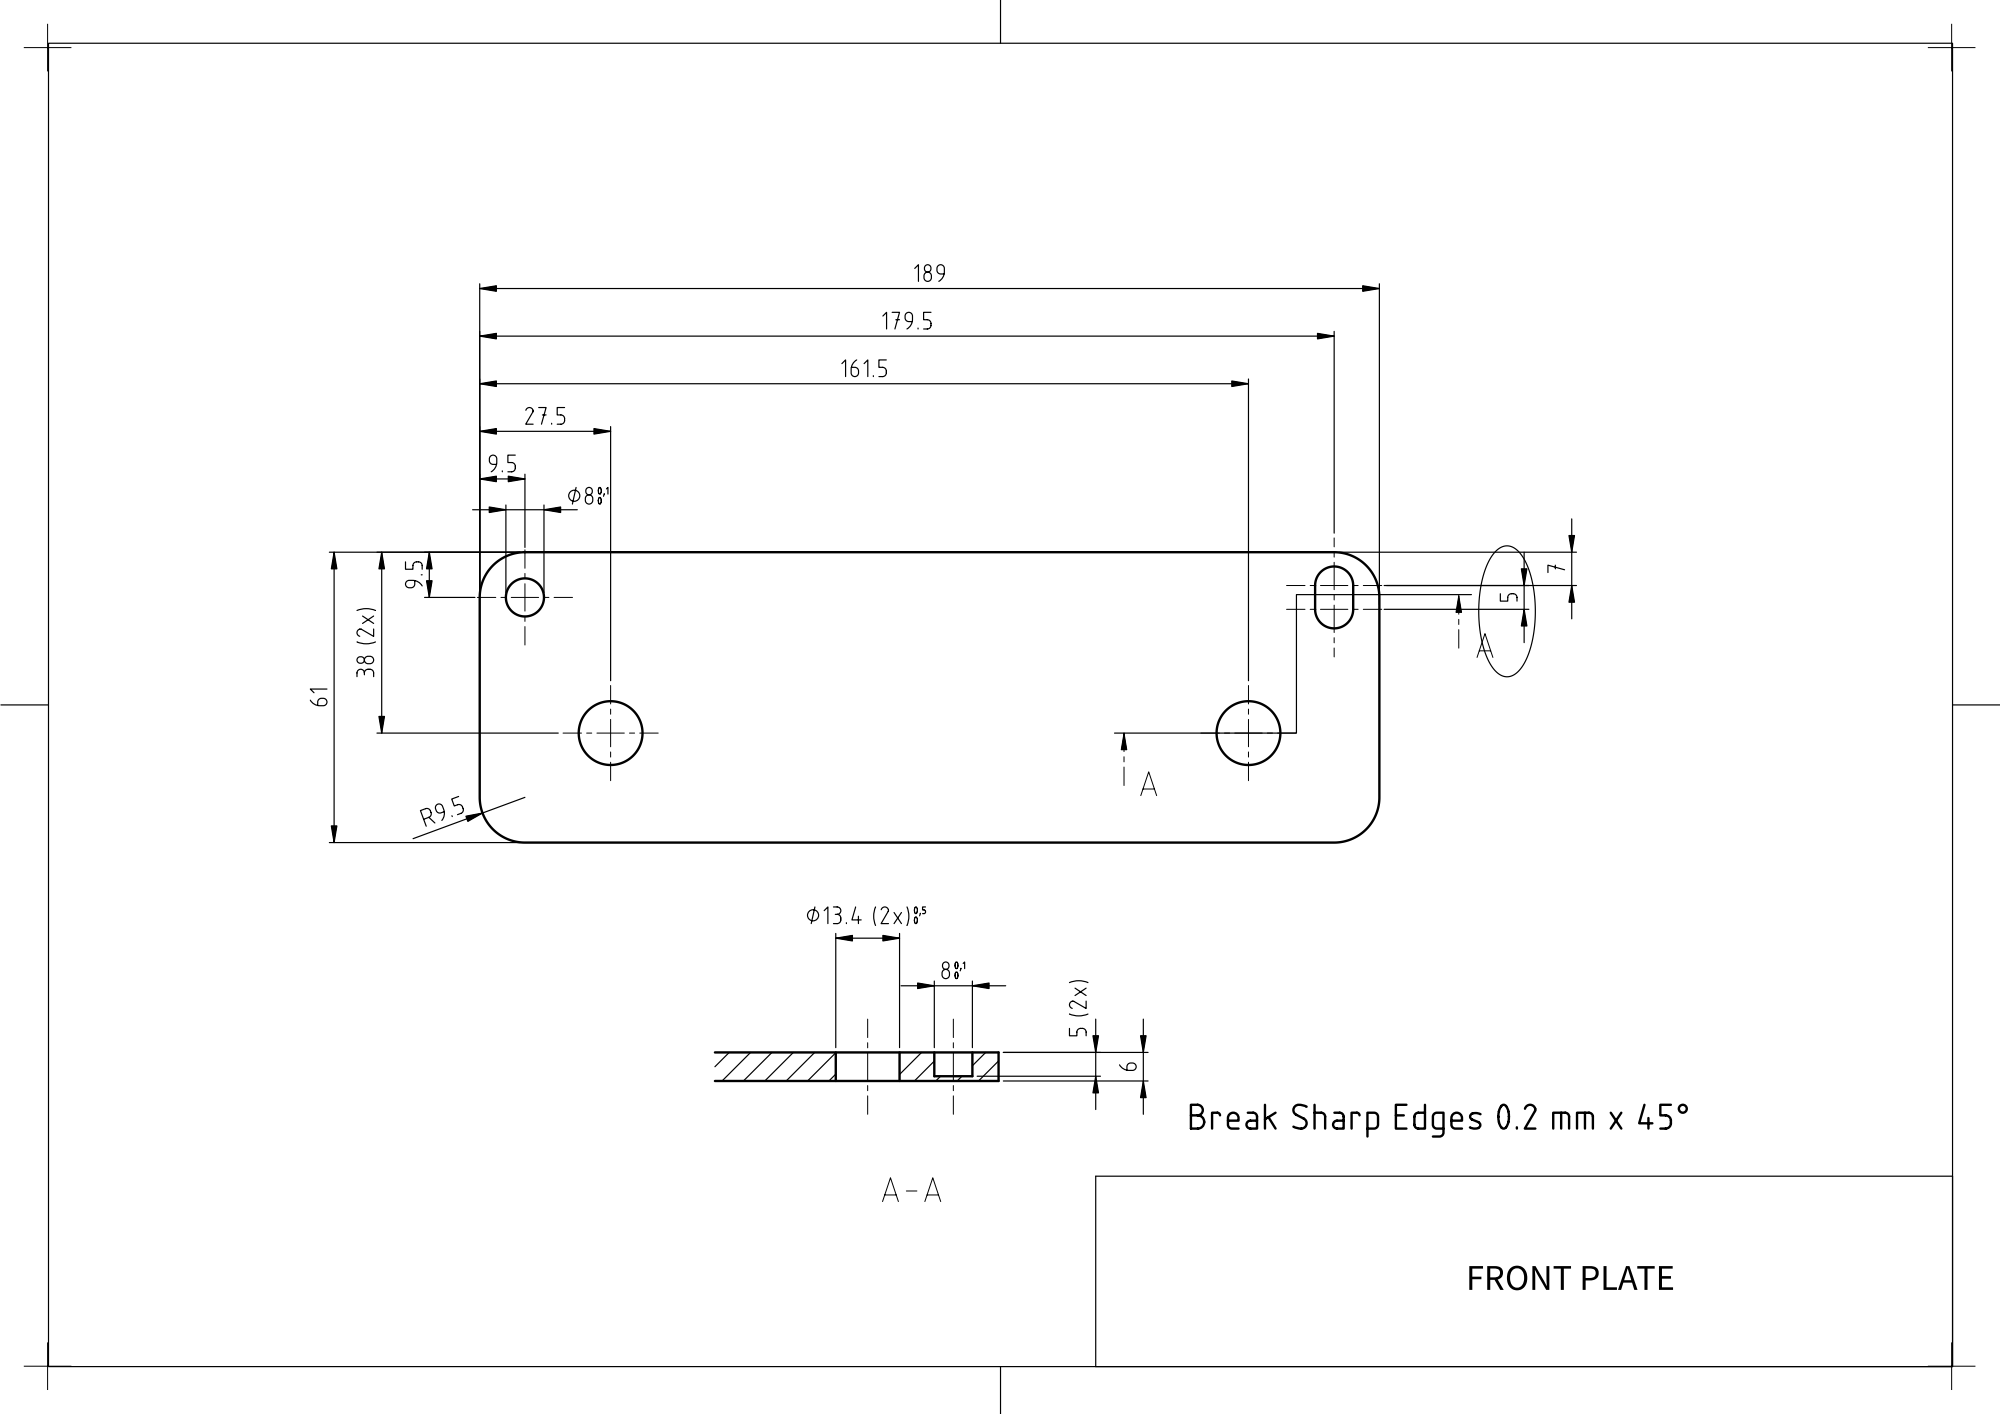
[picture p36: page 1]
