open3dengineering/i3_Berlin/Frame/PDF/i3_Berlin XZ-Plate.pdf

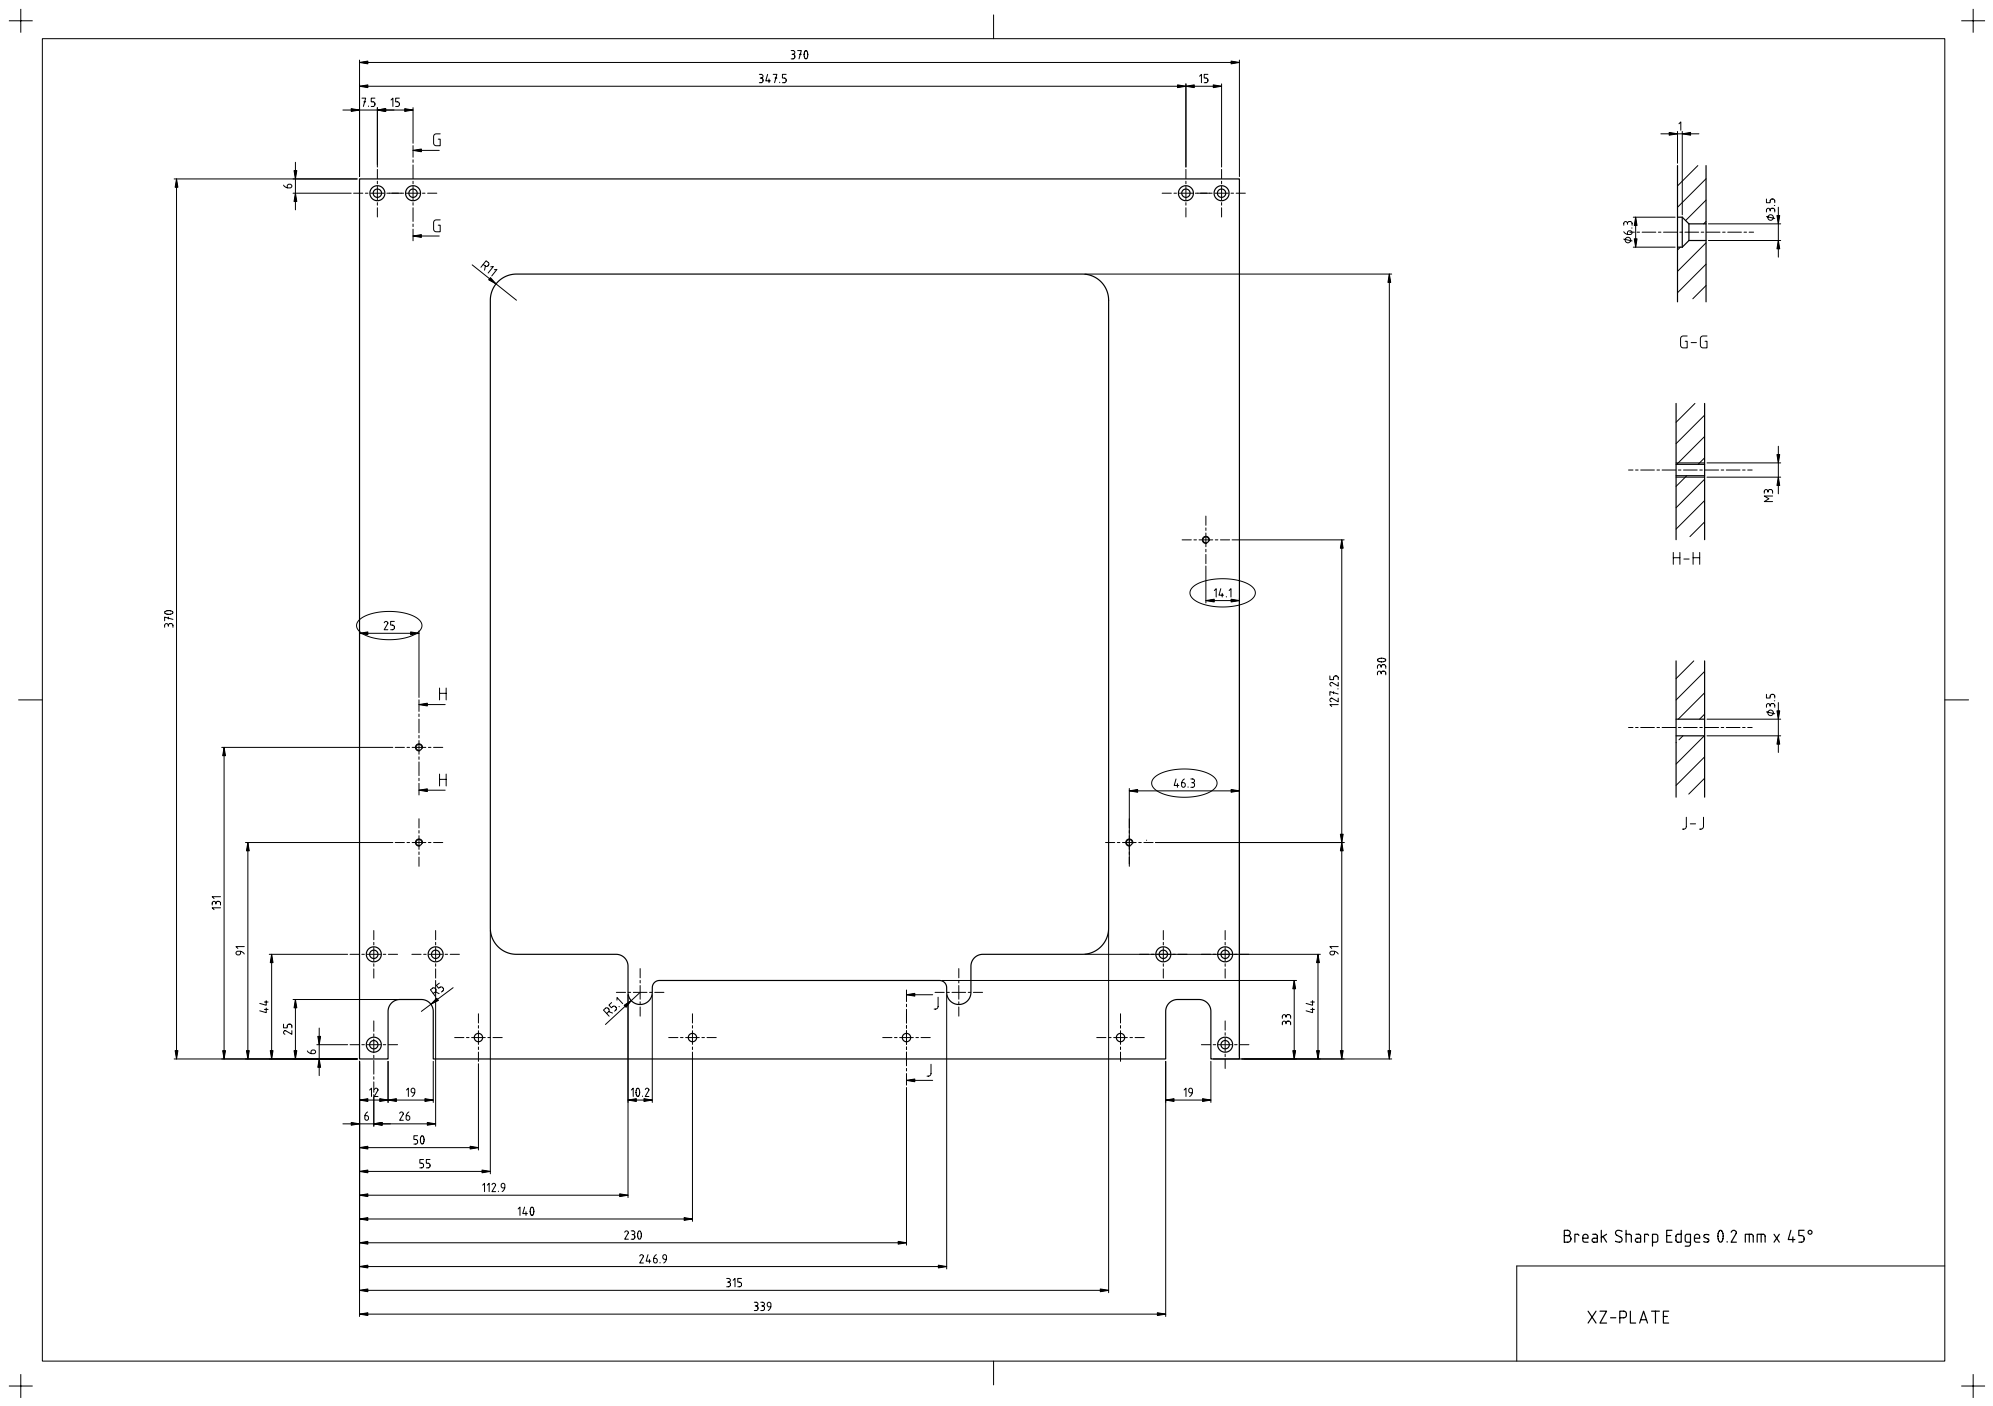
[picture p37: page 1]
