open3dengineering/i3_Berlin/Frame/PDF/i3_Berlin Y-Carriage.pdf

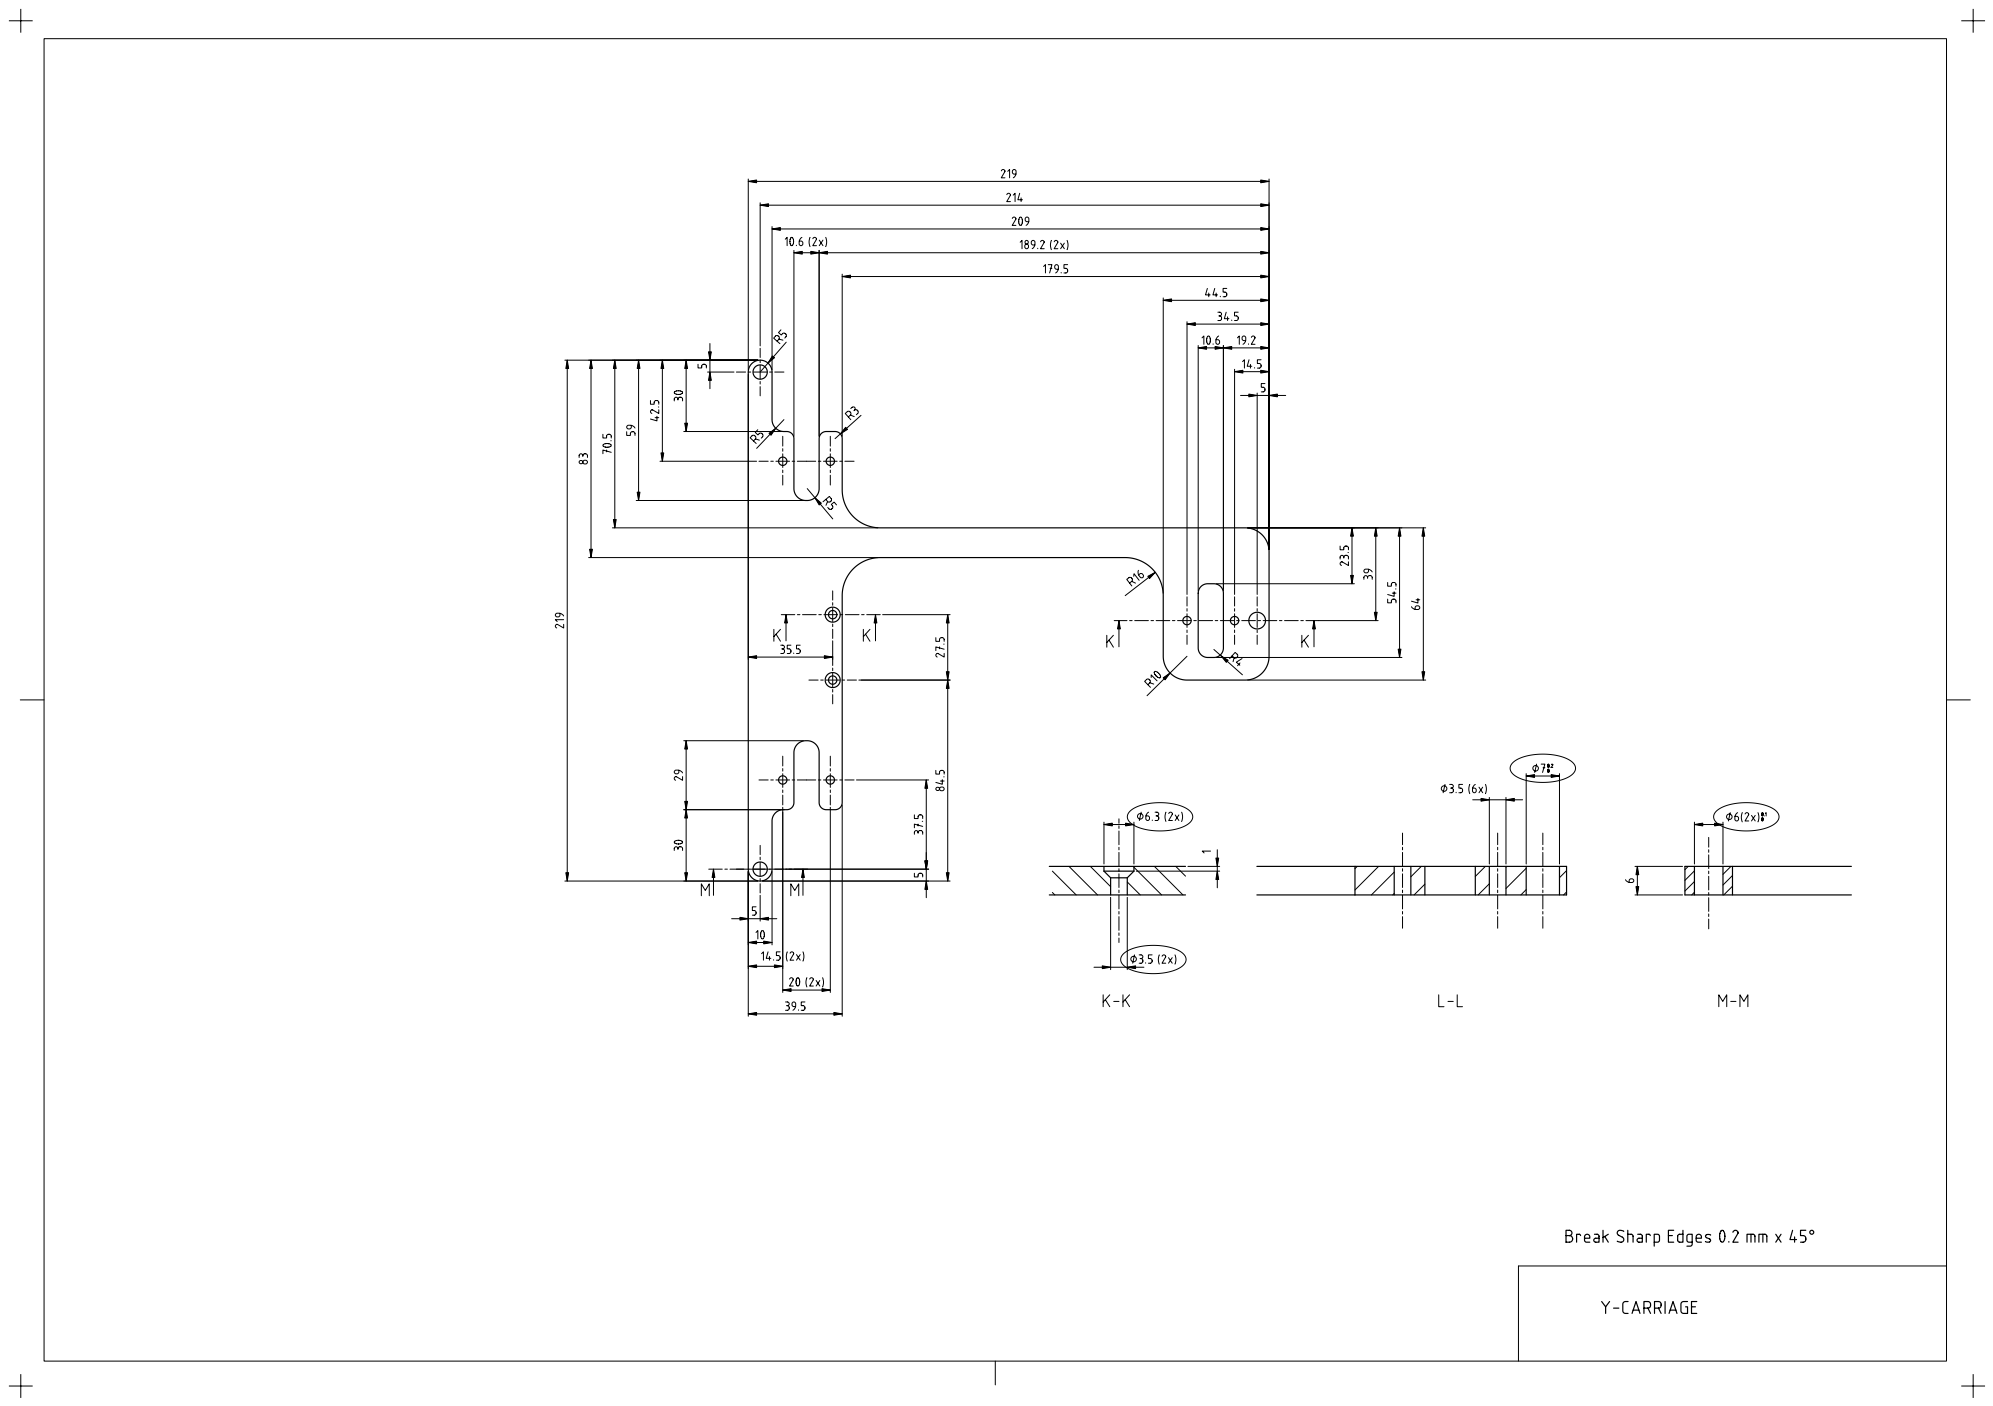
[picture p38: page 1]
