open3dengineering/i3_Berlin/Firmware/RUMBA/Marlin/Configuration_adv.h

#define CONTROLLERFAN_PIN -1 //Pin used for the fan to cool controller (-1 to disable)
#define EXTRUDER_0_AUTO_FAN_PIN   -1
#define EXTRUDER_1_AUTO_FAN_PIN   -1
#define EXTRUDER_2_AUTO_FAN_PIN   -1
#define ENDSTOPS_ONLY_FOR_HOMING // If defined the endstops will only be used for homing
  #define X_HOME_POS MANUAL_X_HOME_POS
  #define Y_HOME_POS MANUAL_Y_HOME_POS
  #define Z_HOME_POS MANUAL_Z_HOME_POS
#define X_HOME_RETRACT_MM 5
#define Y_HOME_RETRACT_MM 5
#define Z_HOME_RETRACT_MM 1
#define MICROSTEP1 LOW,LOW
#define MICROSTEP2 HIGH,LOW
#define MICROSTEP4 LOW,HIGH
#define MICROSTEP8 HIGH,HIGH
#define MICROSTEP16 HIGH,HIGH
#define MICROSTEP_MODES {16,16,16,16,16} // [1,2,4,8,16]
#define DIGIPOT_MOTOR_CURRENT {135,135,135,135,135} // Values 0-255 (RAMBO 135 = ~0.75A, 185 = ~1A)
#define DIGIPOT_I2C_MOTOR_CURRENTS {1.0, 1.0, 1.0, 1.0, 1.0, 1.0, 1.0, 1.0}
