open3dengineering/i3_Berlin/Software/KISSlicer/KISSlicerProfile/_materials.ini

[PLA - Colorfabb]
g_code_matl=3B204D617962652073657420736F6D65206D6174657269616C2D737065636966696320472D636F64653F
fan_Z_mm=1
fan_loops_percent=100
fan_inside_percent=40
fan_cool_percent=100
temperature_C=205
keep_warm_C=150
first_layer_C=205
bed_C=65
sec_per_C_per_C=0
flow_min_mm3_per_s=0.01
flow_max_mm3_per_s=10
destring_suck=0.6
destring_prime=0.75
destring_min_mm=1
destring_trigger_mm=100
destring_speed_mm_per_s=40
Z_lift_mm=0
min_layer_time_s=0
wipe_mm=10
cost_per_cm3=0.12
flowrate_tweak=1
fiber_dia_mm=1.75
color=4294967040

[ABS]
g_code_matl=3B204D617962652073657420736F6D65206D6174657269616C2D737065636966696320472D636F64653F
fan_Z_mm=1
fan_loops_percent=0
fan_inside_percent=0
fan_cool_percent=0
temperature_C=235
keep_warm_C=150
first_layer_C=235
bed_C=110
sec_per_C_per_C=0
flow_min_mm3_per_s=0.01
flow_max_mm3_per_s=10
destring_suck=0.6
destring_prime=0.75
destring_min_mm=1
destring_trigger_mm=100
destring_speed_mm_per_s=40
Z_lift_mm=0
min_layer_time_s=0
wipe_mm=10
cost_per_cm3=0.12
flowrate_tweak=1
fiber_dia_mm=1.74
color=4294967040
