open3dengineering/i3_Berlin/Software/Cura/CuraProfile/preferences.ini

[preference]
startmode = Normal
simplemodeprofile = 2_normal
simplemodematerial = 1_pla
oneatatime = True
lastfile = /Users/user/Downloads/i3_bear.stl
save_profile = False
filament_cost_kg = 30
filament_cost_meter = 0
auto_detect_sd = True
sdcard_rootfolder = /Users/user/
check_for_updates = True
submit_slice_information = True
youmagine_token = 
filament_physical_density = 1240
language = English
active_machine = 0
model_colour = #F8F7FF
model_colour2 = #CB2096
model_colour3 = #DDD93C
model_colour4 = #4550D3
printing_window = Pronterface UI
window_maximized = True
window_pos_x = 29
window_pos_y = 26
window_width = 1280
window_height = 774
window_normal_sash = 389
last_run_version = 15.04

[machine_0]
machine_name = i3 Berlin
machine_type = reprap
machine_width = 190
machine_depth = 190
machine_height = 200
machine_center_is_zero = False
machine_shape = Square
ultimaker_extruder_upgrade = False
has_heated_bed = True
gcode_flavor = RepRap (Marlin/Sprinter)
extruder_amount = 2
extruder_offset_x1 = 0
extruder_offset_y1 = 0
extruder_offset_x2 = 0.0
extruder_offset_y2 = 0.0
extruder_offset_x3 = 0.0
extruder_offset_y3 = 0.0
extruder_offset_x4 = 0.0
extruder_offset_y4 = 0.0
steps_per_e = 0
serial_port = AUTO
serial_port_auto = /dev/cu.usbmodemfd121
serial_baud = 115200
serial_baud_auto = 
extruder_head_size_min_x = 0
extruder_head_size_min_y = 0
extruder_head_size_max_x = 0
extruder_head_size_max_y = 0
extruder_head_size_height = 0
