open3dengineering/i3_Berlin/Software/KISSlicer/KISSlicerProfile/_styles.ini

[i3 Berlin - Low Res - 20% Infill]
layer_thickness_mm=0.4
extrusion_width_mm=0.4
num_loops=3
skin_thickness_mm=1.2
infill_extrusion_width=0.4
infill_density_denominator=4
stacked_layers=1
use_destring=1
use_wipe=1
loops_insideout=1
infill_st_oct_rnd=1
inset_surface_xy_mm=0.2
seam_jitter_degrees=0
seam_depth_scaler=0.5

[i3 Berin - Medium Res - 20% Infill]
layer_thickness_mm=0.2
extrusion_width_mm=0.4
num_loops=3
skin_thickness_mm=1.2
infill_extrusion_width=0.4
infill_density_denominator=4
stacked_layers=1
use_destring=1
use_wipe=1
loops_insideout=1
infill_st_oct_rnd=1
inset_surface_xy_mm=0.2
seam_jitter_degrees=0
seam_depth_scaler=0.5

[i3 Berlin - High Res - 20% infill]
layer_thickness_mm=0.1
extrusion_width_mm=0.4
num_loops=3
skin_thickness_mm=1.2
infill_extrusion_width=0.4
infill_density_denominator=4
stacked_layers=1
use_destring=1
use_wipe=1
loops_insideout=1
infill_st_oct_rnd=1
inset_surface_xy_mm=0.2
seam_jitter_degrees=0
seam_depth_scaler=0.5
