open3dengineering/i3_Berlin/(commit log)

2013-09-19 Complete Design
    This is the complete design.
    It has most of the manual done in key frames.
    This commit is mainly for progress functions
2013-09-20 moved Design->Blender and added Frame dir
    [i3_berlin_frame.dxf]
2013-09-20 added Frame png because of github not rendering svg's hosted in a repository
2013-09-20 updated Frame Readme.asciidoc
2013-09-25 added python BOM generator
2013-09-26 added BOM in mainfolder
    [BOM.csv]
2013-09-26 Updated printer design. 75% by now
2013-09-30 Animation Toolbox, progress on wiring and parts
2013-09-30 Finalized single parts, wiring half way.
2013-10-02 Added and updated X and Y wiring
2013-10-09 Many Cables Added, Display casing update
2013-10-10 X Cables Added
2013-10-11 Updated BOM
    [BOM.csv]
2013-10-11 Bom in correct Directory
    [BOM.csv]
2013-10-12 update BOM.csv wit tinyurls
    [BOM.csv]
2013-10-14 updated BOM.csv
    [BOM.csv]
2013-10-14 updated BOM.csv again
    [BOM.csv]
2013-10-14 updated BOM (internal)
2013-10-15 Added wires, cleanups, renaming
2013-10-15 All Cables modelled, Y Unit manual frames finished
2013-10-24 updated cables, interactive movement
2013-10-30 extruder, wires, name updates
    [BOM.csv]
2013-10-31 single parts frame completed, start new extruder
2013-11-01 bom added
    [BOM.csv]
2013-11-04 added Marlin Firmware
    [Configuration.h, Configuration_adv.h, Menu Plans.xlsx]
2013-11-04 turned on PID for E3D, max positions
    [Configuration.h]
2013-11-06 update Marlin firmware
    [Configuration.h, Menu Plans.xlsx]
2013-11-22 Dual Extruder added
    [BOM.csv]
2014-01-02 updated default home position in Firmware
    [Configuration.h]
2014-01-03 updated frame plate
    [i3_berlin_frame.dxf]
2014-01-03 updated extruder
2014-01-06 Cleaned up Printed Parts Layer
    [i3_berlin_frame.dxf]
2014-01-06 updated frame
    [i3_berlin_frame.dxf]
2014-02-18 added RUMBA Firmware and Slicer Presets
    [Configuration.h, Configuration_adv.h, Menu Plans.xlsx]
2014-02-26 changed frame: optimized for 10mm mill and different extruder hole position
    [i3_berlin_frame.dxf]
2014-02-26 mirror error in frame backplate fixed
    [i3_berlin_frame.dxf]
2014-02-26 added frame png files
2014-02-26 added hole for ground in frame back-plate
    [i3_berlin_frame.dxf]
2014-02-27 fix Y-Carriage in Frame
    [i3_berlin_frame.dxf]
2014-03-04 printed parts new version. RUMBA case not finished. BOM not finished. Manual not finished.
2014-03-07 updates on printed parts
2014-03-10 updated hole info in frame
    [i3_berlin_frame.dxf]
2014-03-10 updated BOM for screws
    [BOM.csv]
2014-03-11 cleaned up, prepared manual for extruder
2014-03-15 fixed inverted z-endstop-holder
2014-03-20 changed Rumba config
    [Configuration.h]
2014-04-02 general changes
    [BOM.csv, Configuration.h, i3_berlin_frame.dxf]
2014-04-10 changes in Z motor holder and Y Beltholder
2014-04-12 fixed dual extrusion end.gcode in Cura
2014-04-14 added technical cross sections of the extruder parts in the frame drawing dxf
    [i3_berlin_frame.dxf]
2014-04-20 heavy heavy clean up of the Blender file
    [BOM.csv, i3_berlin_frame.dxf]
2014-04-22 debug extruder fanholder
2014-04-22 reverted BOM to old state
    [BOM.csv]
2014-04-22 fixed bom_addon.py to work only on objects in current scene
2014-04-22 updated BOM.csv from .blend in 'Total Assembly' scene
    [BOM.csv]
2014-04-23 updated Rumba firmware Config
    [Configuration.h]
2014-05-14 small updates
    [Configuration.h]
2014-07-08 Update to ACME Rods
    [Configuration.h]
2014-08-19 added new Marlin Firmware for RUMBA with ACME rod and Filament Change Menu
    [Configuration.h, Configuration_adv.h, Menu Plans.xlsx]
2014-09-12 added KISSlicerProfile again, was exidently deleted
    [Configuration.h]
2015-02-04 added stls, big printer update
    [ActiveCoolingDuct.stl, BeltGuidingDisc.stl, CableHolder.stl, DisplayCaseCorner.stl, ExtruderCenterLeft.stl, ExtruderCenterRight.stl, ExtruderFanHolder.stl, Extruder_E3D_FanDuct.stl]
2015-04-15 changed Configuration.h in firmware
    - HOMING_FEEDRATE for z changed from 26*60 to 10*60 to don't jam new z spindels
    - DEFAULT_AXIS_STEPS_PER_UNIT adjusted z steps to new spindle, extruder steps from 157.5 to 158 to run more smoth
    - DEFAULT_MAX_FEEDRATE for z to 10 to prevent jamming
    [Configuration.h]
2015-04-20 construction updates
    [ExtruderCenterLeft.stl, ExtruderCenterRight.stl, X_Carriage.stl]
2015-06-05 fixed ejerk
    [Configuration.h]
2015-06-18 Fixes #19
    [XBearingHolderLeft.stl, XBearingHolderRight.stl]
2015-06-21 changed preheat fan speed to 0
    [Configuration.h]
2015-07-05 adjustment of default maximal z feedrate
    [Configuration.h]
2015-07-06 update Mechanics
    [CableHolder.stl]
2015-08-17 updated frames files
    [i3_berlin_frame.dxf]
